Acliad/XBOX-Sign/Hardware/Light Board - O/Release/Production/BOM.csv

Reference | Description | Qty | Comment | LCSC | MPN
D1, D2, D3, D4, D5, D6, D7, D8 | Light emitting diode, filled shape | 8 |  |  | JB2835AWT-W-H40GA0000-N0000001
