Acliad/XBOX-Sign/Hardware/Control Board/Mechanical/Board Outline.dxf

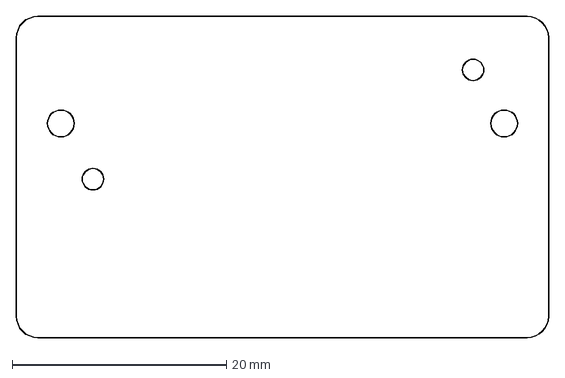
[picture p1: CAD file, 2025-08-16]
Hardware/Control Board/Mechanical/Board Outline.dxf
49.7 x 30.0 mm
