Acliad/XBOX-Sign/Hardware/Light Board - B/Mechanical/Board Outline.dxf

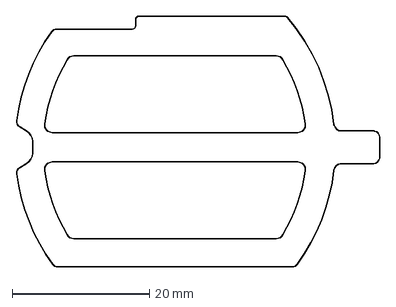
[picture p2: CAD file, 2025-08-16]
Hardware/Light Board - B/Mechanical/Board Outline.dxf
53.0 x 36.6 mm
