Acliad/XBOX-Sign/Hardware/Light Board - B/Release/Mechanical/Light Board - B.step

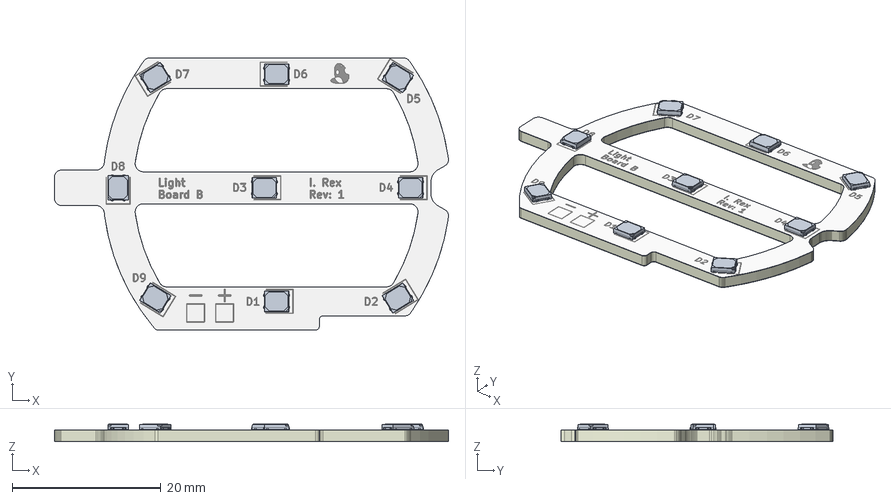
[picture p3: CAD file, 2025-08-30]
Hardware/Light Board - B/Release/Mechanical/Light Board - B.step
53.0 x 36.6 x 2.36 mm
Light Board - B 1.1.1 x 9
Light Board - B_silkscreen
Light Board - B_soldermask
Light Board - B_PCB
