Acliad/XBOX-Sign/Hardware/Light Board - O/Release/Mechanical/Light Board - O.step

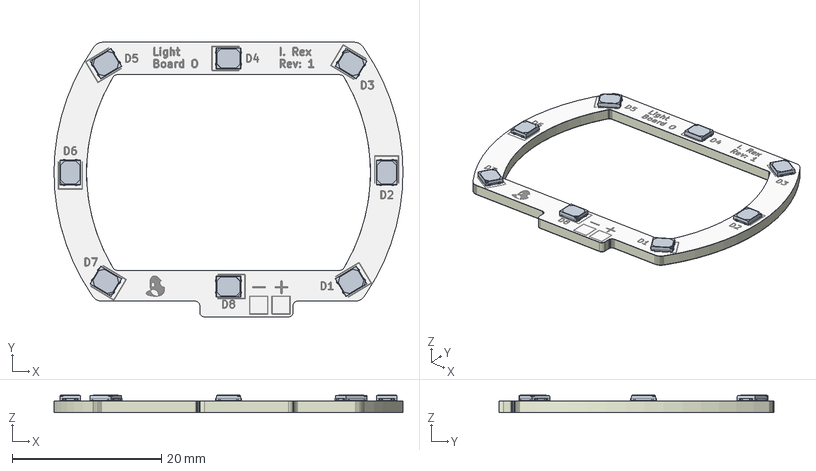
[picture p4: CAD file, 2025-08-30]
Hardware/Light Board - O/Release/Mechanical/Light Board - O.step
46.8 x 36.8 x 2.36 mm
Light Board - O 1.1.1 x 8
Light Board - O_silkscreen
Light Board - O_soldermask
Light Board - O_PCB
