Acliad/XBOX-Sign/Hardware/Light Board - Symbol/Mechanical/LED Placement.dxf

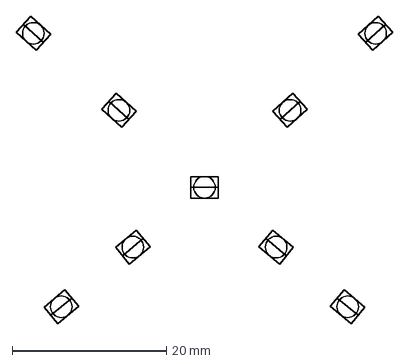
[picture p5: CAD file, 2025-08-16]
Hardware/Light Board - Symbol/Mechanical/LED Placement.dxf
48.8 x 39.8 mm
