Acliad/XBOX-Sign/Hardware/Light Board - Symbol/Release/Mechanical/Light Board - Symbol.step

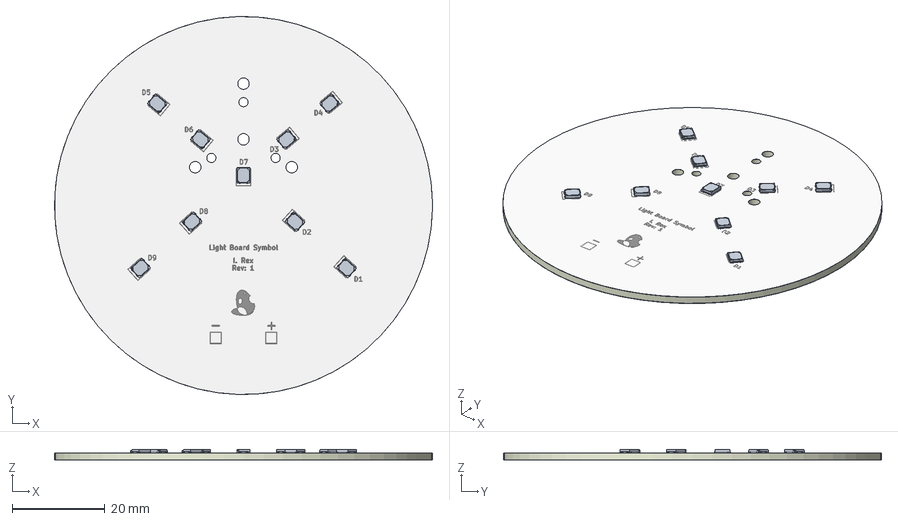
[picture p6: CAD file, 2025-08-30]
Hardware/Light Board - Symbol/Release/Mechanical/Light Board - Symbol.step
81.4 x 81.4 x 2.36 mm
Light Board - Symbol 1.1.1 x 9
Light Board - Symbol_silkscreen
Light Board - Symbol_soldermask
Light Board - Symbol_PCB
