Acliad/XBOX-Sign/Hardware/Light Board - X/Release/Mechanical/Light Board - X.step

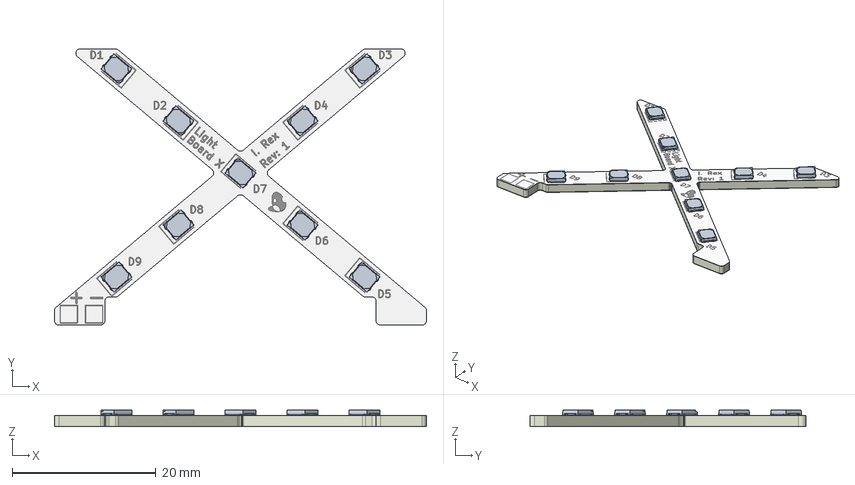
[picture p7: CAD file, 2025-08-30]
Hardware/Light Board - X/Release/Mechanical/Light Board - X.step
51.7 x 38.4 x 2.36 mm
Light Board - X 1.1.1 x 9
Light Board - X_silkscreen
Light Board - X_soldermask
Light Board - X_PCB
