Acliad/XBOX-Sign/Hardware/USB-C Board/Mechanical/Board Outline.dxf

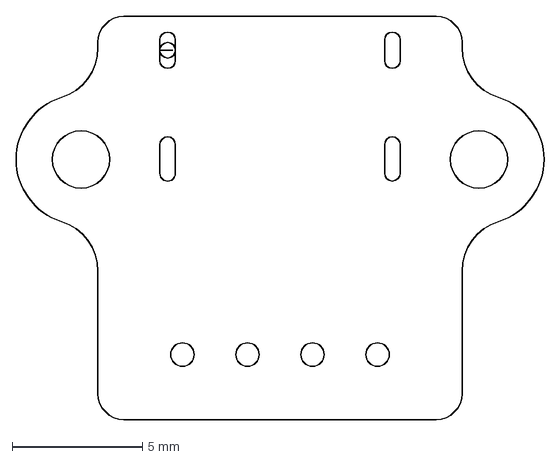
[picture p8: CAD file, 2025-08-16]
Hardware/USB-C Board/Mechanical/Board Outline.dxf
20.3 x 15.5 mm
