Acliad/XBOX-Sign/Hardware/USB-C Board/Release/Mechanical/USB-C Board.step

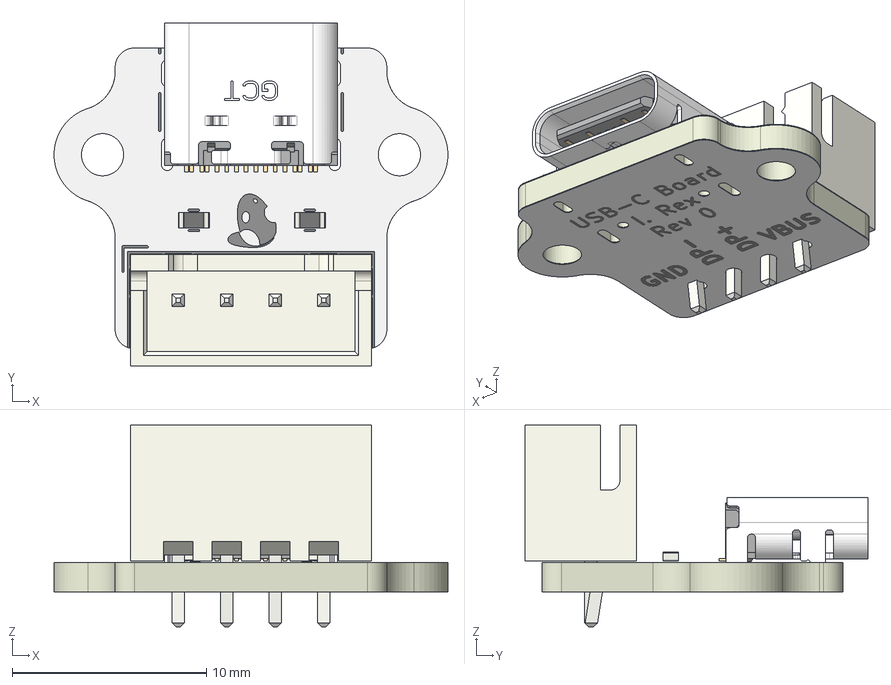
[picture p9: CAD file, 2025-08-16]
Hardware/USB-C Board/Release/Mechanical/USB-C Board.step
20.3 x 17.7 x 10.4 mm
R_0603_1608Metric x 2
JST_XH_B4B-XH-A_1x04_P2.50mm_Vertical
USB4105-15-A-120_PART2
USB4105-15-A-120_PART1
USB-C Board_silkscreen
USB-C Board_soldermask
USB-C Board_PCB
