Acliad/XBOX-Sign/Hardware/Light Board - B/Mechanical/LED Placement.dxf

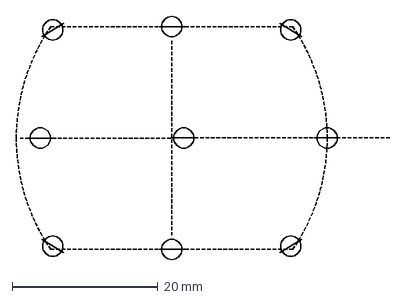
[picture p10: CAD file, 2025-08-16]
Hardware/Light Board - B/Mechanical/LED Placement.dxf
51.2 x 33.4 mm
