Acliad/XBOX-Sign/Hardware/Light Board - Symbol/Mechanical/Board Outline.dxf

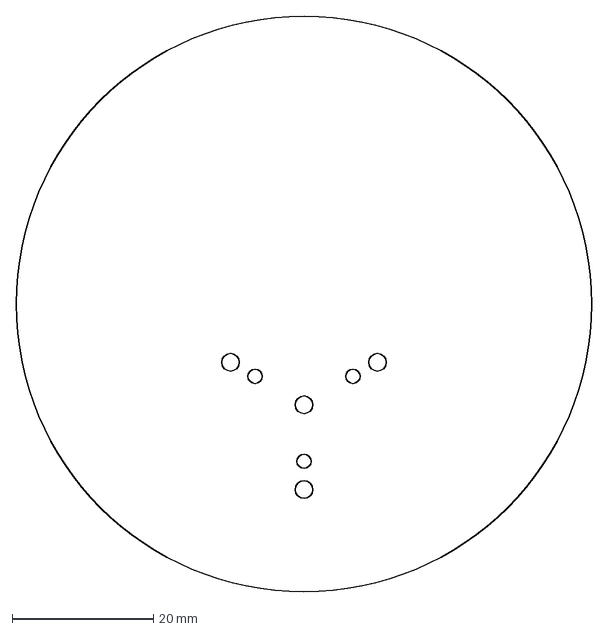
[picture p11: CAD file, 2025-08-16]
Hardware/Light Board - Symbol/Mechanical/Board Outline.dxf
81.4 x 81.4 mm
