Acliad/XBOX-Sign/Hardware/Light Board - O/Mechanical/LED Placement.dxf

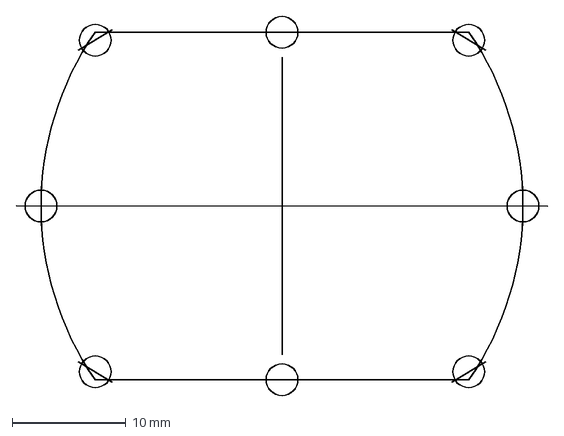
[picture p12: CAD file, 2025-08-11, an earlier design]
Hardware/Light Board - O/Mechanical/LED Placement.dxf
46.8 x 33.4 mm
