Acliad/XBOX-Sign/Hardware/Light Board - X/Mechanical/LED Placement.dxf

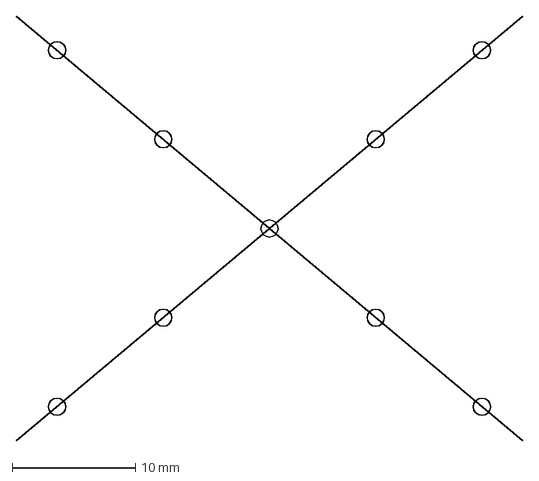
[picture p13: CAD file, 2025-08-10, an earlier design]
Hardware/Light Board - X/Mechanical/LED Placement.dxf
41.1 x 34.5 mm
