Acliad/XBOX-Sign/Hardware/Light Board - O/Mechanical/Board Outline.dxf

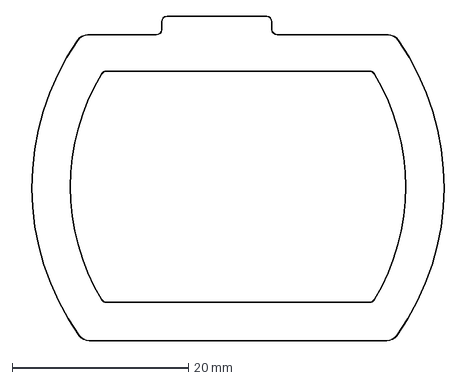
[picture p14: CAD file, 2025-08-11, an earlier design]
Hardware/Light Board - O/Mechanical/Board Outline.dxf
50.4 x 36.8 mm
