Acliad/XBOX-Sign/Hardware/Light Board - X/Mechanical/Board Outline.dxf

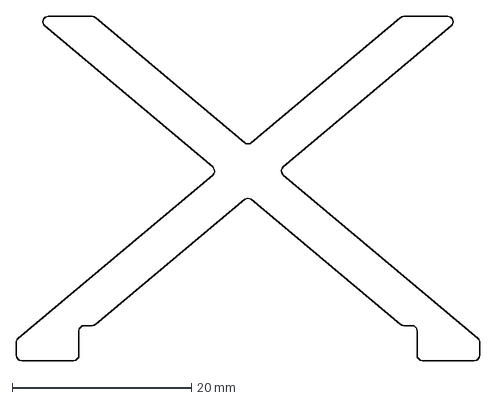
[picture p15: CAD file, 2025-08-10, an earlier design]
Hardware/Light Board - X/Mechanical/Board Outline.dxf
51.7 x 38.4 mm
