Acliad/XBOX-Sign/Hardware/Light Board - B/Release/PDFs/Light Board - B.pdf

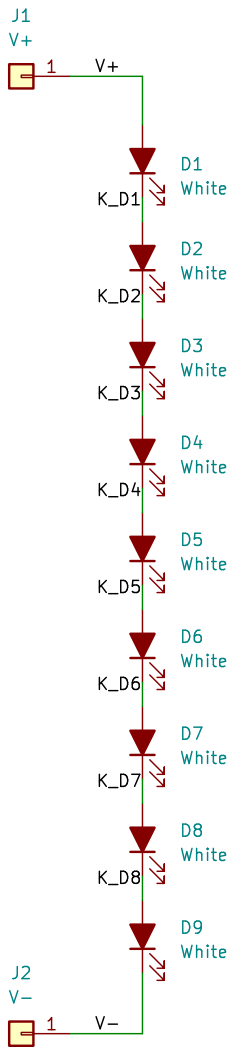
[picture p16: page 1]

File: Light Board - B.kicad_sch Light Board - B
