Acliad/XBOX-Sign/Hardware/Light Board - B/Release/PDFs/Light Board - B_ASY.pdf

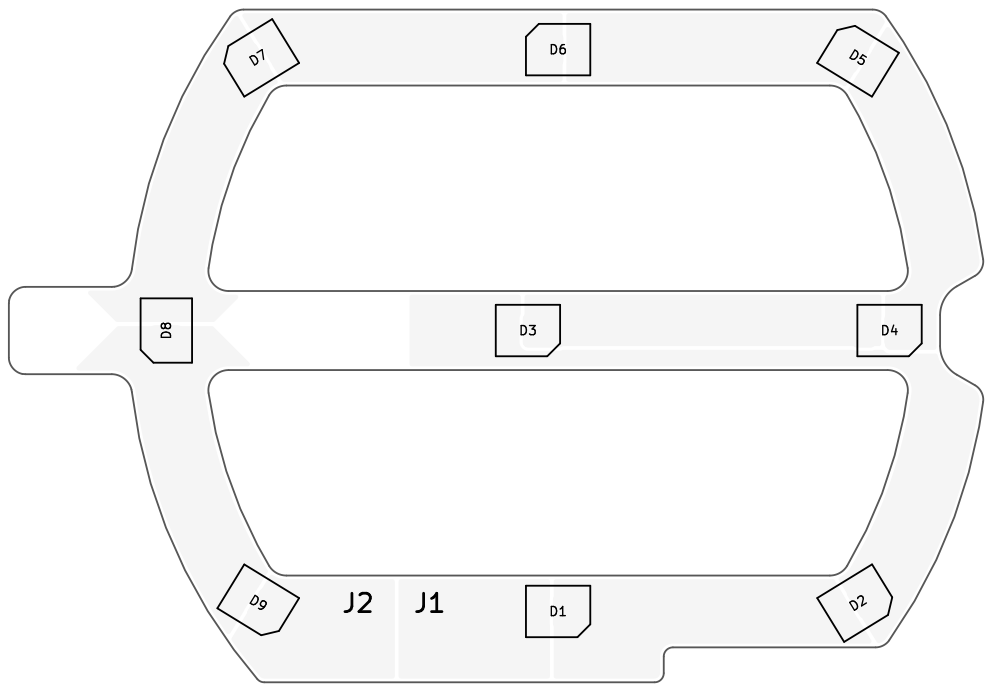
[picture p17: page 1]

File: Light Board - B.kicad_pcb Light Board - B

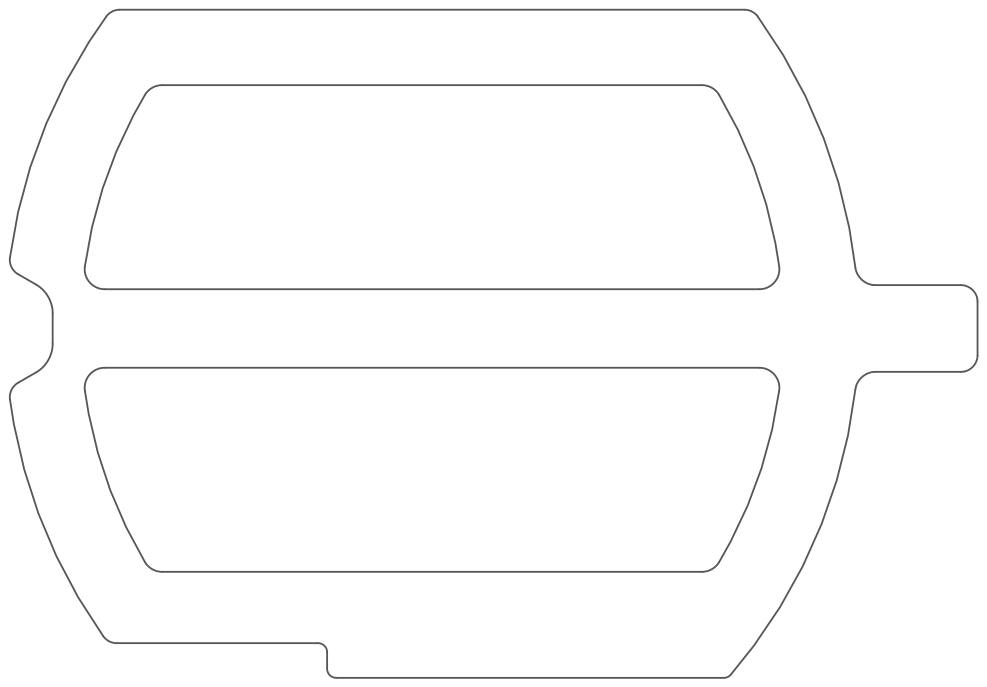
[picture p18: page 2]
D Date: 2025-08-10 Rev: 1; Size: A; Engineer: Isaac; Rex; ECAD Version; ${KICAD_VERSION}

File: Light Board - B.kicad_pcb Light Board - B
Sheet: 2/2 Assembly - Bottom
