Acliad/XBOX-Sign/Hardware/Light Board - B/Release/PDFs/Light Board - B_FAB.pdf

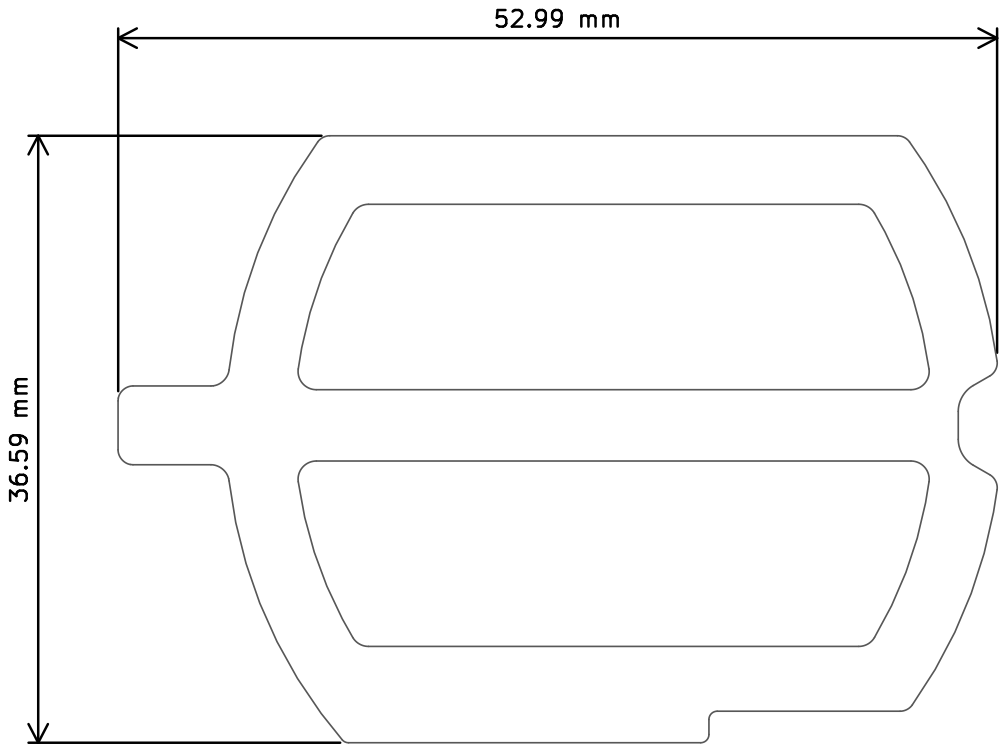
[picture p19: page 1]
D Date: 2025-08-10 Rev: 1; Size: A; Sheet:; 1/7 Fab Drawing; Engineer: Isaac; Rex; ECAD Version; ${KICAD_VERSION}

File: Light Board - B.kicad_pcb Light Board - B

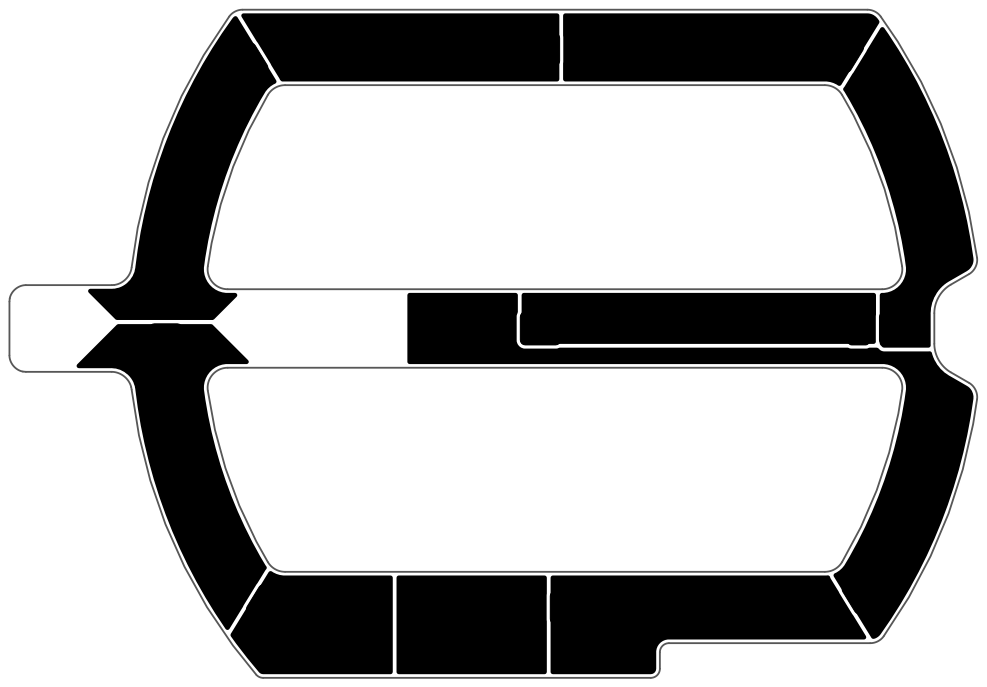
[picture p20: page 2]
D Date: 2025-08-10 Rev: 1; Size: A; Sheet: 2/7 Copper - L1; Engineer: Isaac; Rex; ECAD Version

File: Light Board - B.kicad_pcb Light Board - B

File: Light Board - B.kicad_pcb Light Board - B

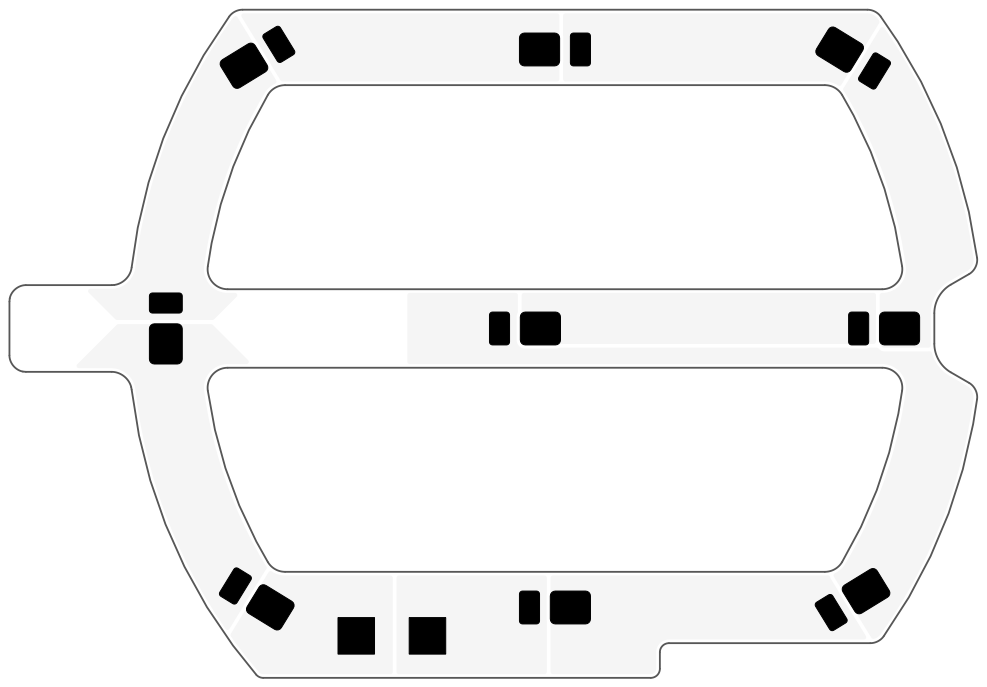
[picture p21: page 4]
D Date: 2025-08-10 Rev: 1; Size: A; Engineer: Isaac; Rex; ECAD Version

File: Light Board - B.kicad_pcb Light Board - B
Sheet: 4/7 Soldermask - Top

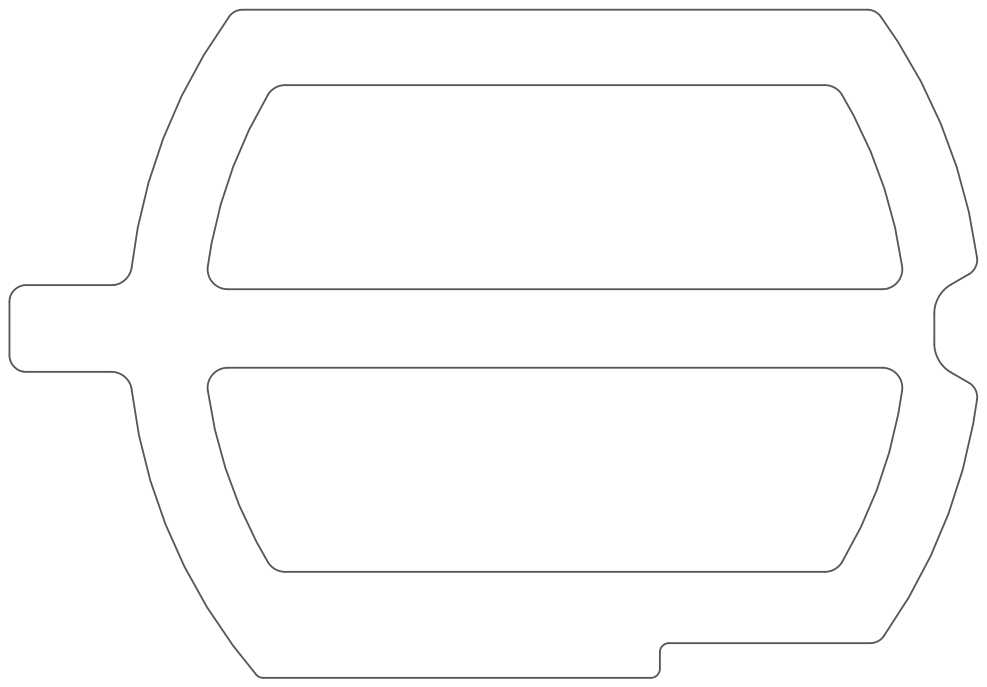
[picture p22: page 5]
D Date: 2025-08-10 Rev: 1; Size: A; Engineer: Isaac; Rex; ECAD Version

File: Light Board - B.kicad_pcb Light Board - B
Sheet: 5/7 Soldermask - Bottom

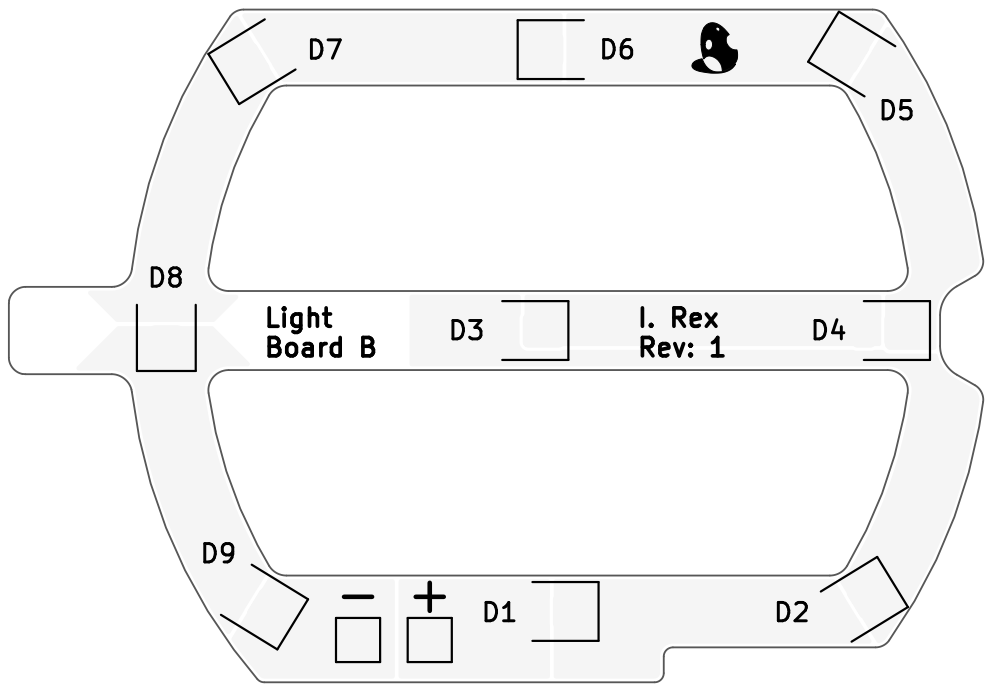
[picture p23: page 6]

File: Light Board - B.kicad_pcb Light Board - B
Sheet: 6/7 Silkscreen - Top

File: Light Board - B.kicad_pcb Light Board - B
Sheet: 7/7 Silk - Bottom
