Acliad/XBOX-Sign/Hardware/Light Board - O/Release/PDFs/Light Board - O.pdf

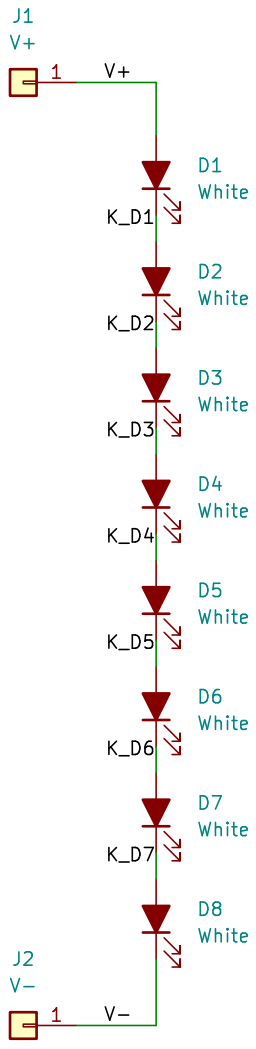
[picture p24: page 1]

File: Light Board - O.kicad_sch Light Board - O
