Acliad/XBOX-Sign/Hardware/Light Board - O/Release/PDFs/Light Board - O_ASY.pdf

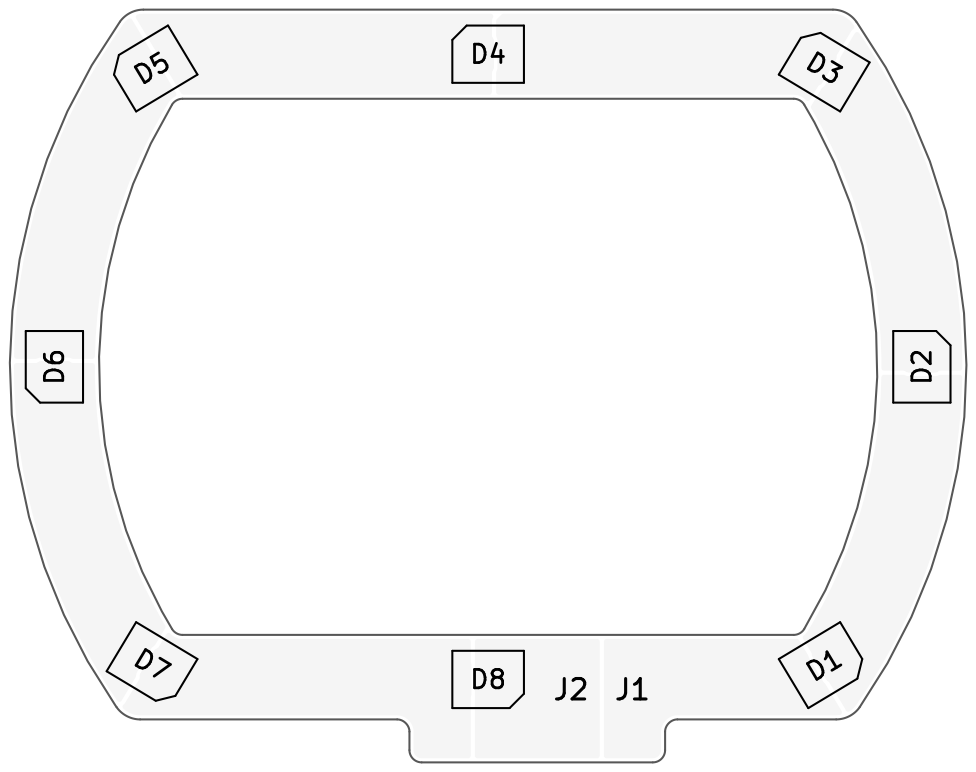
[picture p25: page 1]
D Date: 2025-08-10 Rev: 1; Size: A; Sheet:; 1/2 Assembly - Top; Engineer: Isaac; Rex; ECAD Version; ${KICAD_VERSION}

File: Light Board - O.kicad_pcb Light Board - O

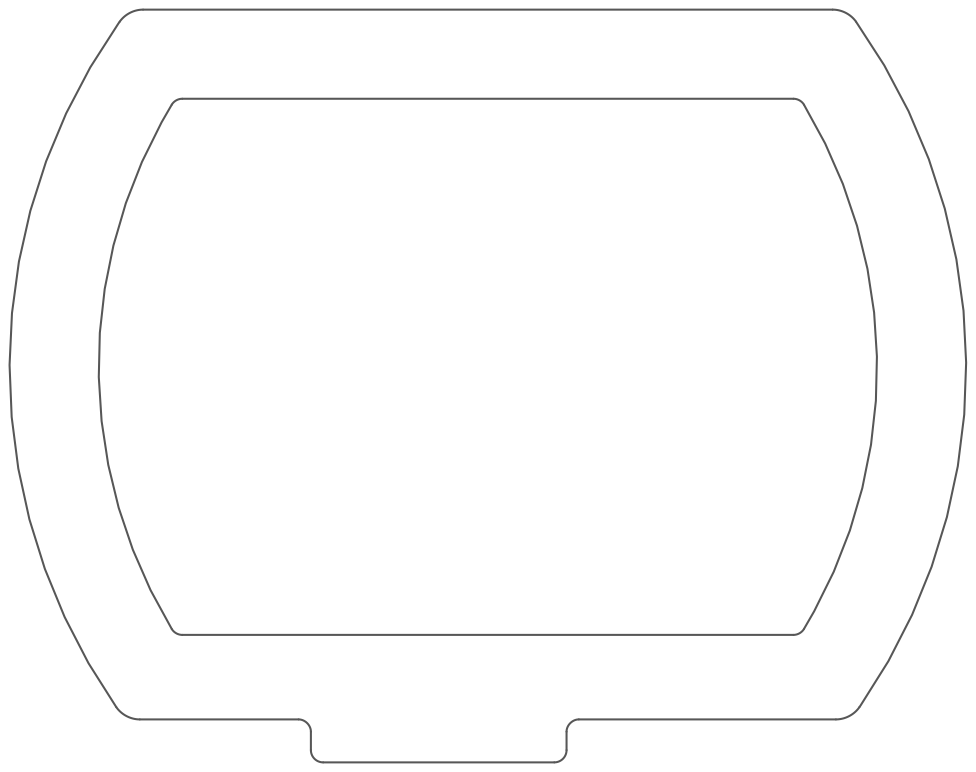
[picture p26: page 2]
D Date: 2025-08-10 Rev: 1; Size: A; Engineer: Isaac; Rex; ECAD Version; ${KICAD_VERSION}

File: Light Board - O.kicad_pcb Light Board - O
Sheet: 2/2 Assembly - Bottom
