Acliad/XBOX-Sign/Hardware/Light Board - O/Release/PDFs/Light Board - O_FAB.pdf

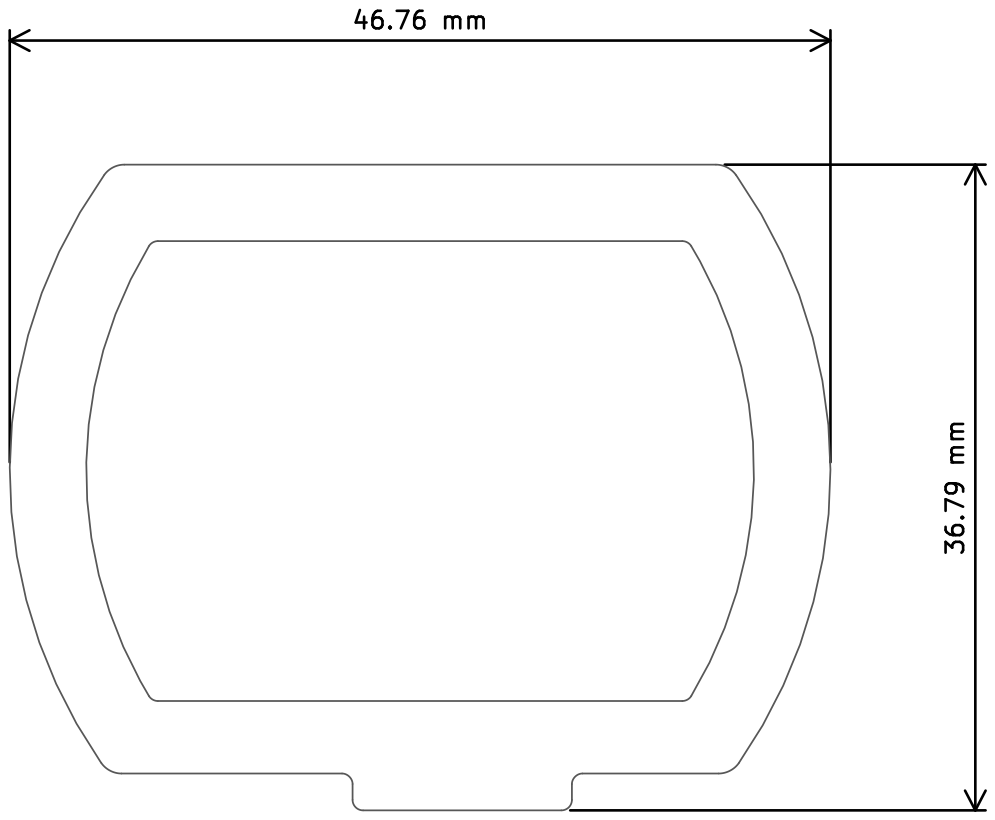
[picture p27: page 1]
D Date: 2025-08-10 Rev: 1; Size: A; Sheet:; 1/7 Fab Drawing; Engineer: Isaac; Rex; ECAD Version; ${KICAD_VERSION}

File: Light Board - O.kicad_pcb Light Board - O

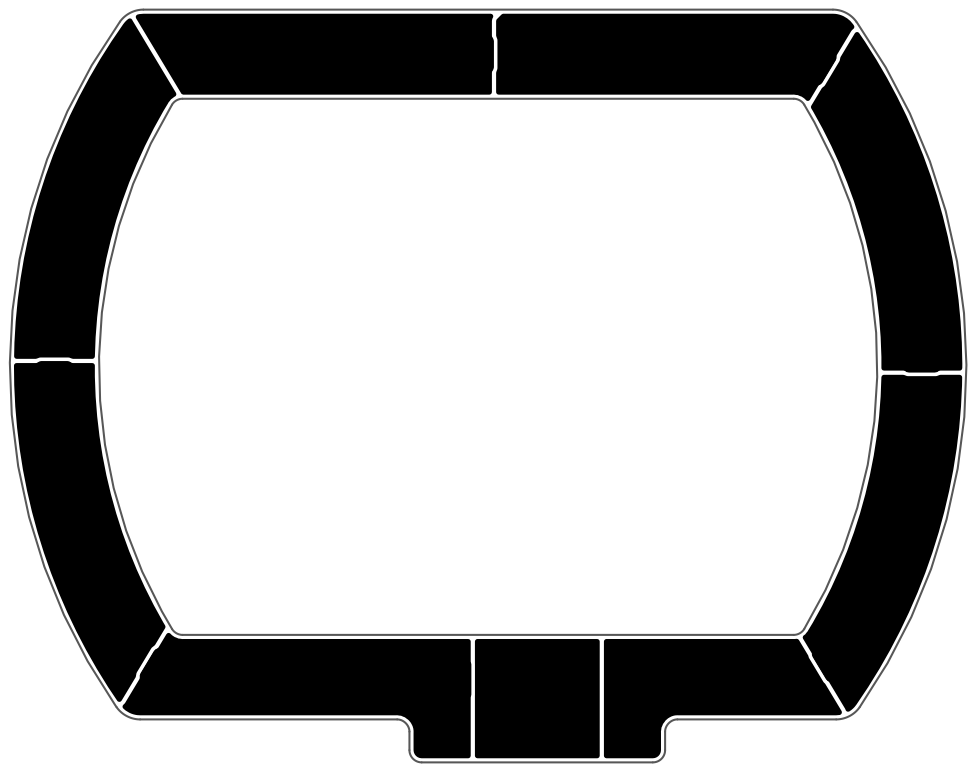
[picture p28: page 2]
D Date: 2025-08-10 Rev: 1; Size: A; Sheet: 2/7 Copper - L1; Engineer: Isaac; Rex; ECAD Version

File: Light Board - O.kicad_pcb Light Board - O

File: Light Board - O.kicad_pcb Light Board - O

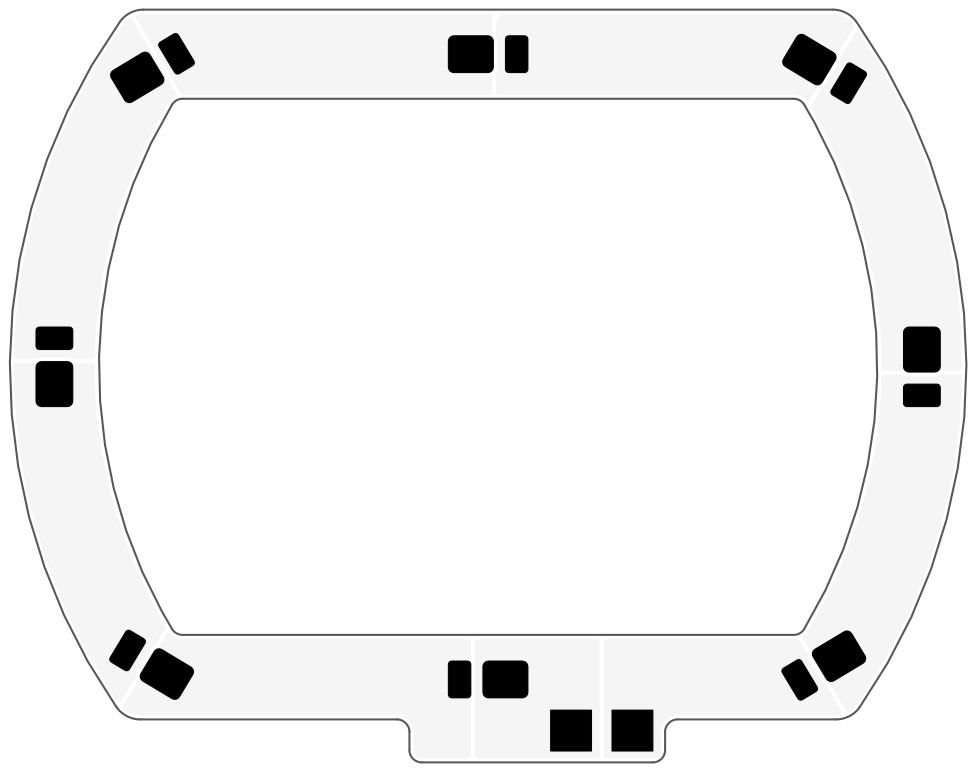
[picture p29: page 4]
D Date: 2025-08-10 Rev: 1; Size: A; Engineer: Isaac; Rex; ECAD Version

File: Light Board - O.kicad_pcb Light Board - O
Sheet: 4/7 Soldermask - Top

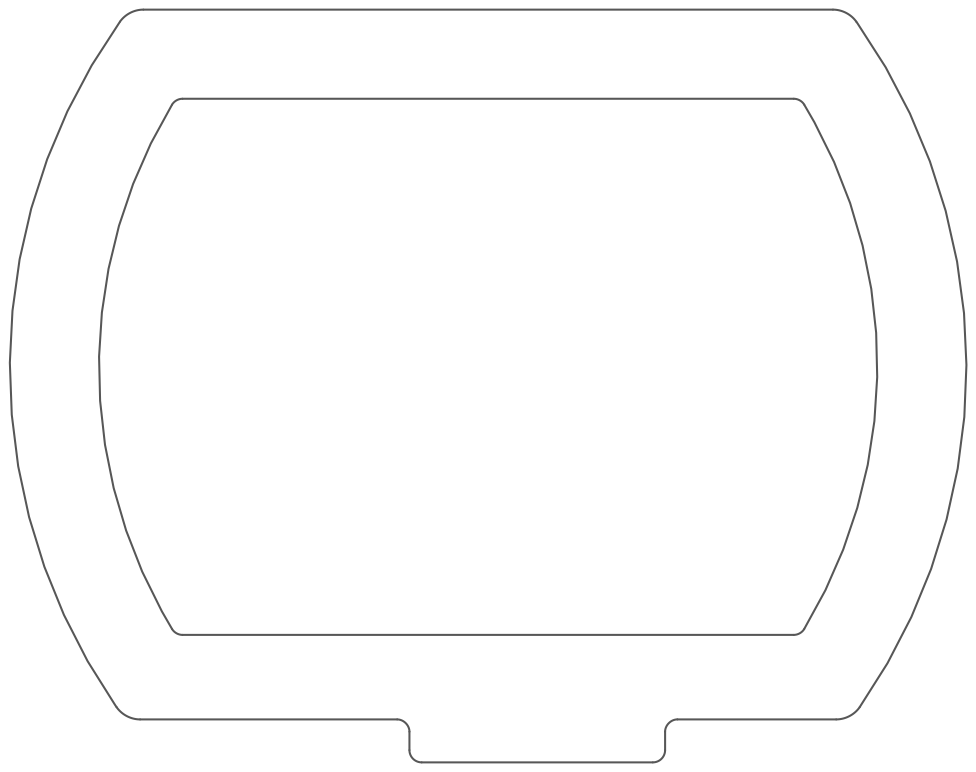
[picture p30: page 5]
D Date: 2025-08-10 Rev: 1; Size: A; Engineer: Isaac; Rex; ECAD Version

File: Light Board - O.kicad_pcb Light Board - O
Sheet: 5/7 Soldermask - Bottom

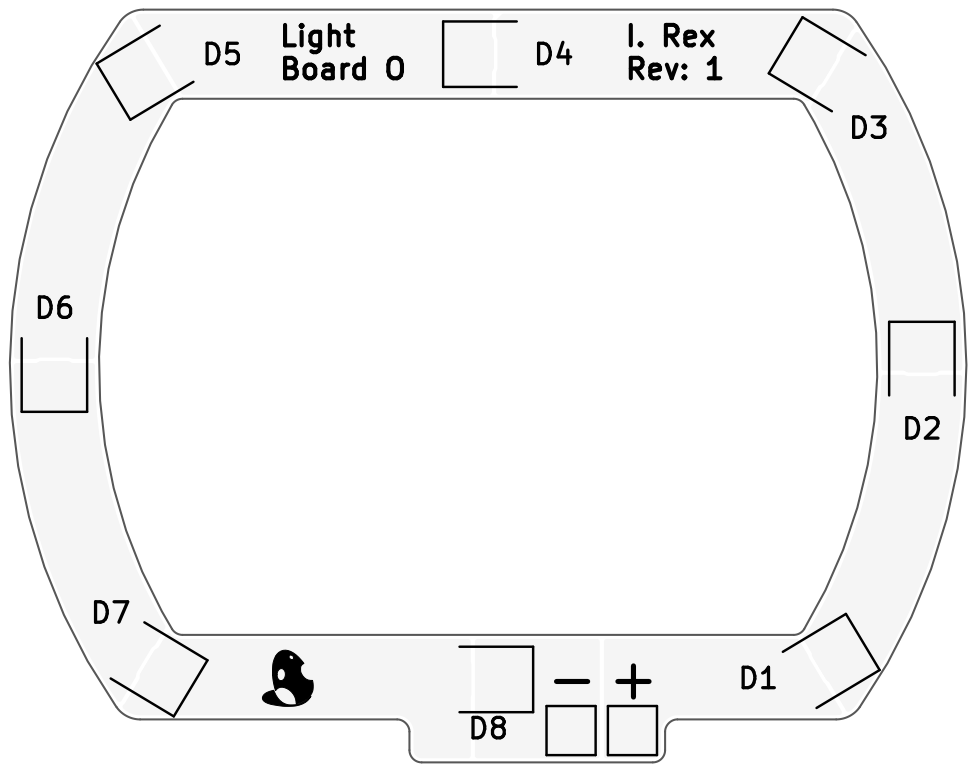
[picture p31: page 6]

File: Light Board - O.kicad_pcb Light Board - O
Sheet: 6/7 Silkscreen - Top

File: Light Board - O.kicad_pcb Light Board - O
Sheet: 7/7 Silk - Bottom
