Acliad/XBOX-Sign/Hardware/Light Board - Symbol/Release/PDFs/Light Board - Symbol.pdf

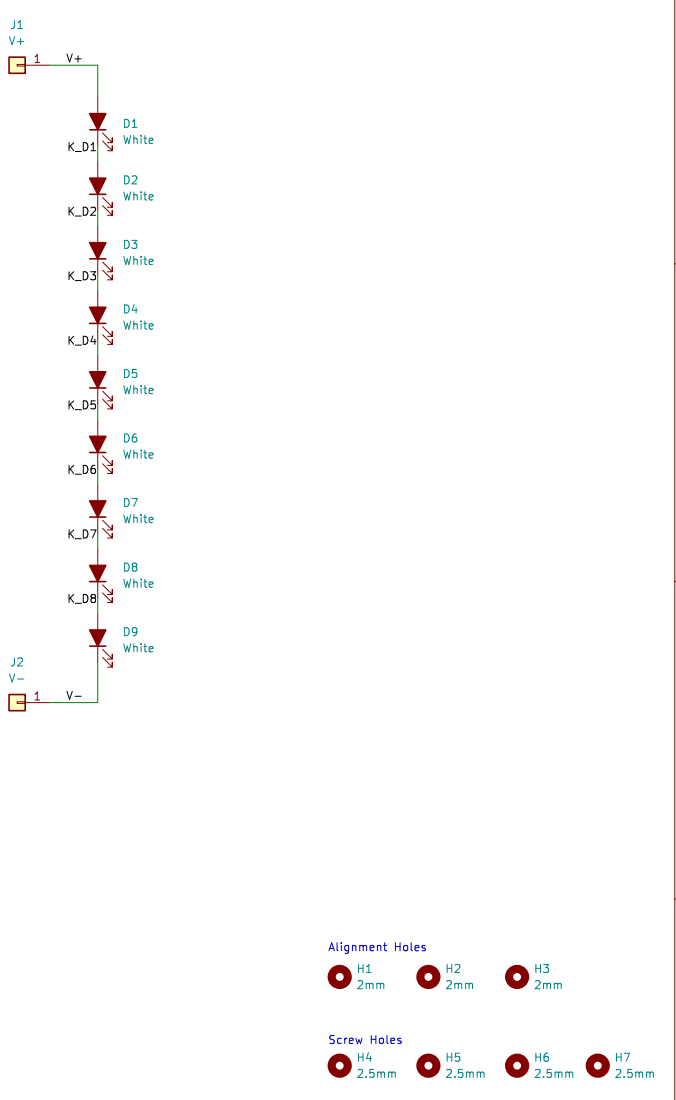
[picture p32: page 1]

File: Light Board - Symbol.kicad_sch Light Board - Symbol
