Acliad/XBOX-Sign/Hardware/Light Board - Symbol/Release/PDFs/Light Board - Symbol_ASY.pdf

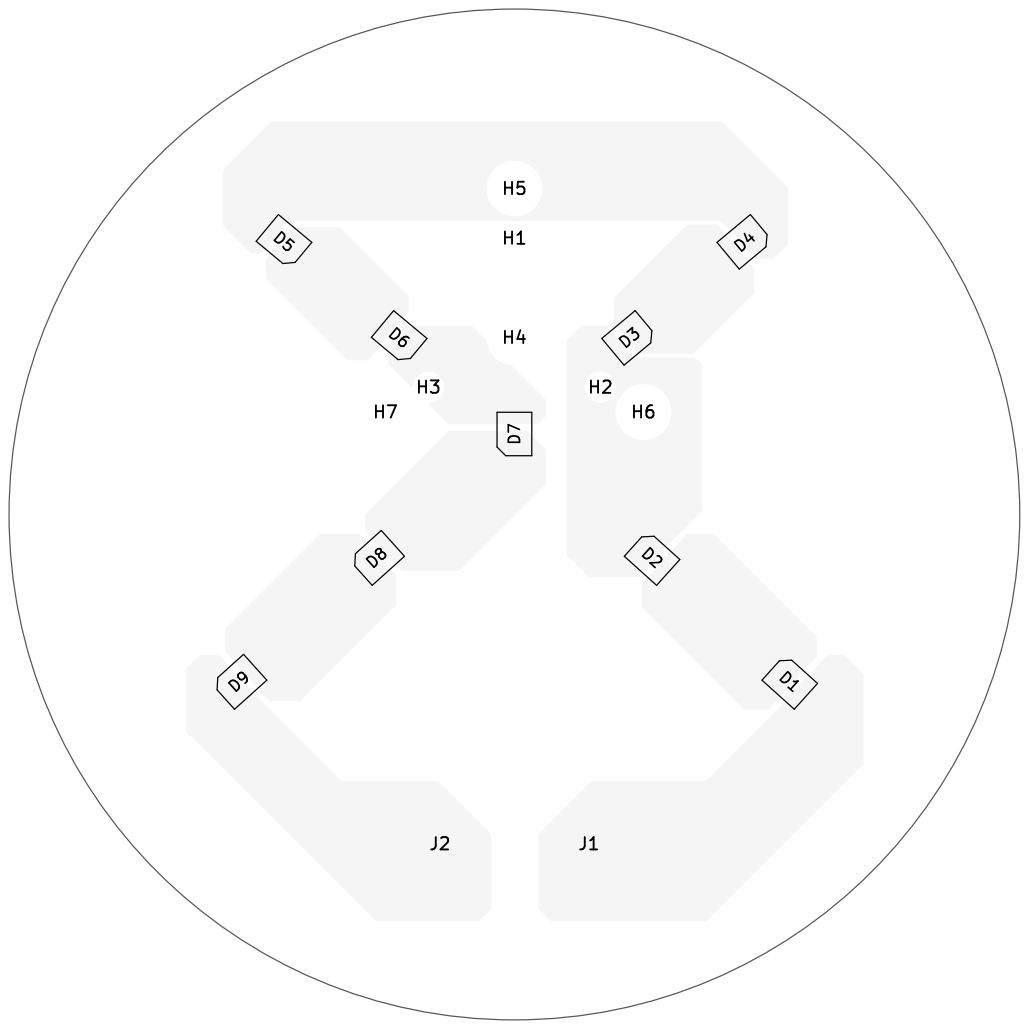
[picture p33: page 1]

File: Light Board - Symbol.kicad_pcb Light Board - Symbol

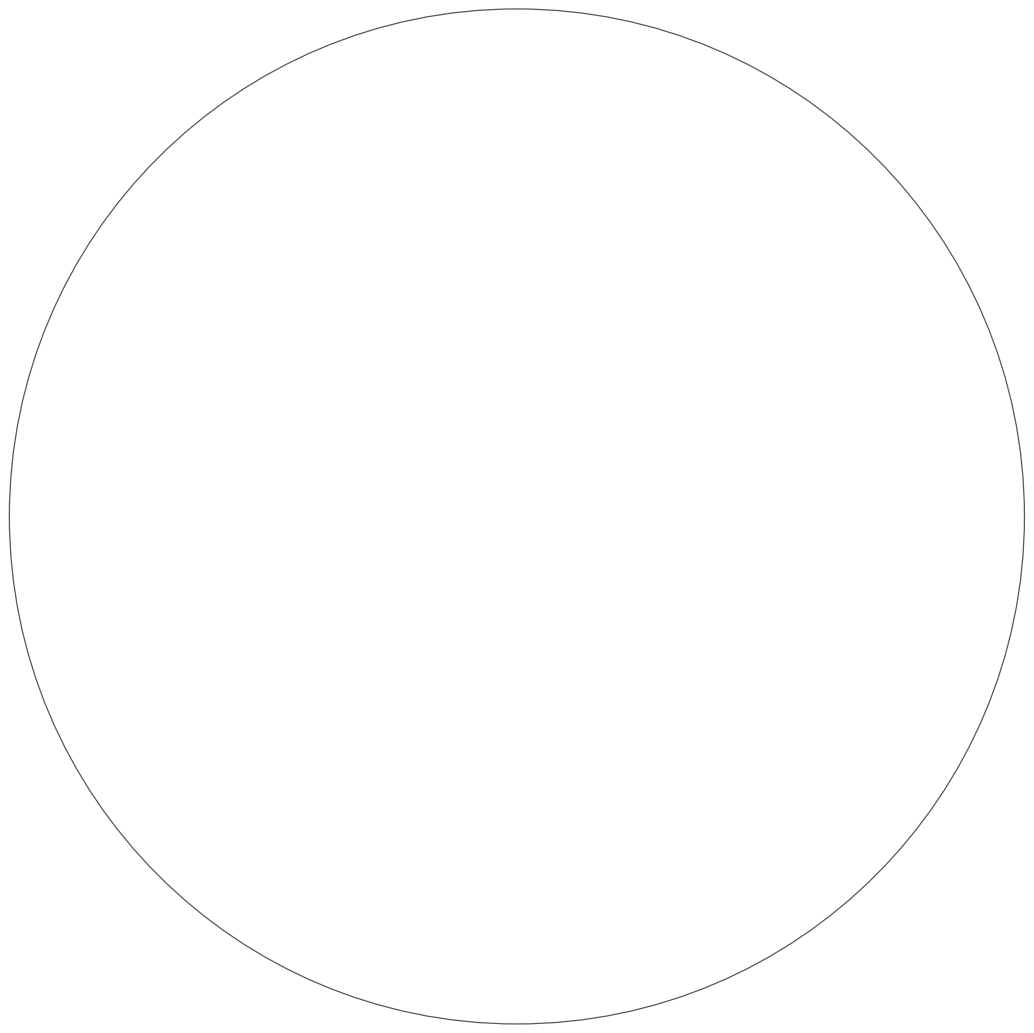
[picture p34: page 2]
D Date: 2025-08-10 Rev: 1; Size: A; Engineer: Isaac; Rex; ECAD Version; ${KICAD_VERSION}

File: Light Board - Symbol.kicad_pcb Light Board - Symbol
Sheet: 2/2 Assembly - Bottom
