Acliad/XBOX-Sign/Hardware/Light Board - Symbol/Release/PDFs/Light Board - Symbol_FAB.pdf

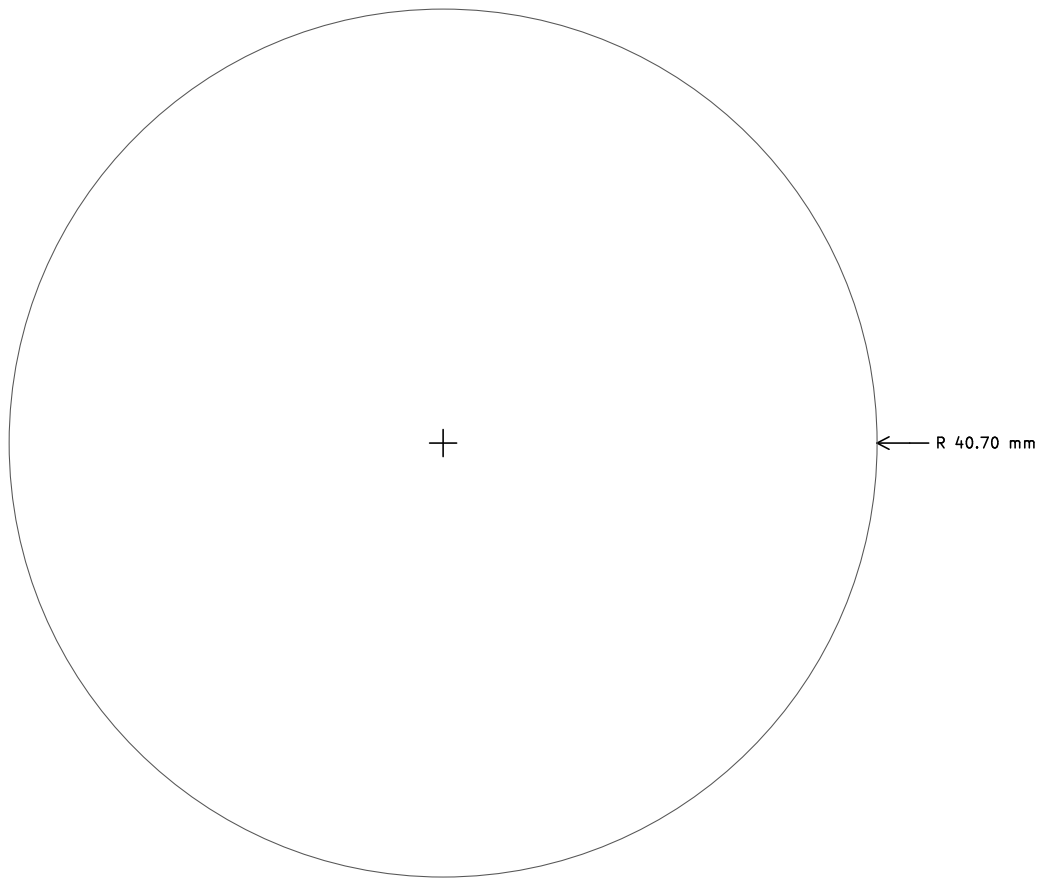
[picture p35: page 1]
D Date: 2025-08-10 Rev: 1; Size: A; Sheet:; 1/7 Fab Drawing; Engineer: Isaac; Rex; ECAD Version; ${KICAD_VERSION}

File: Light Board - Symbol.kicad_pcb Light Board - Symbol

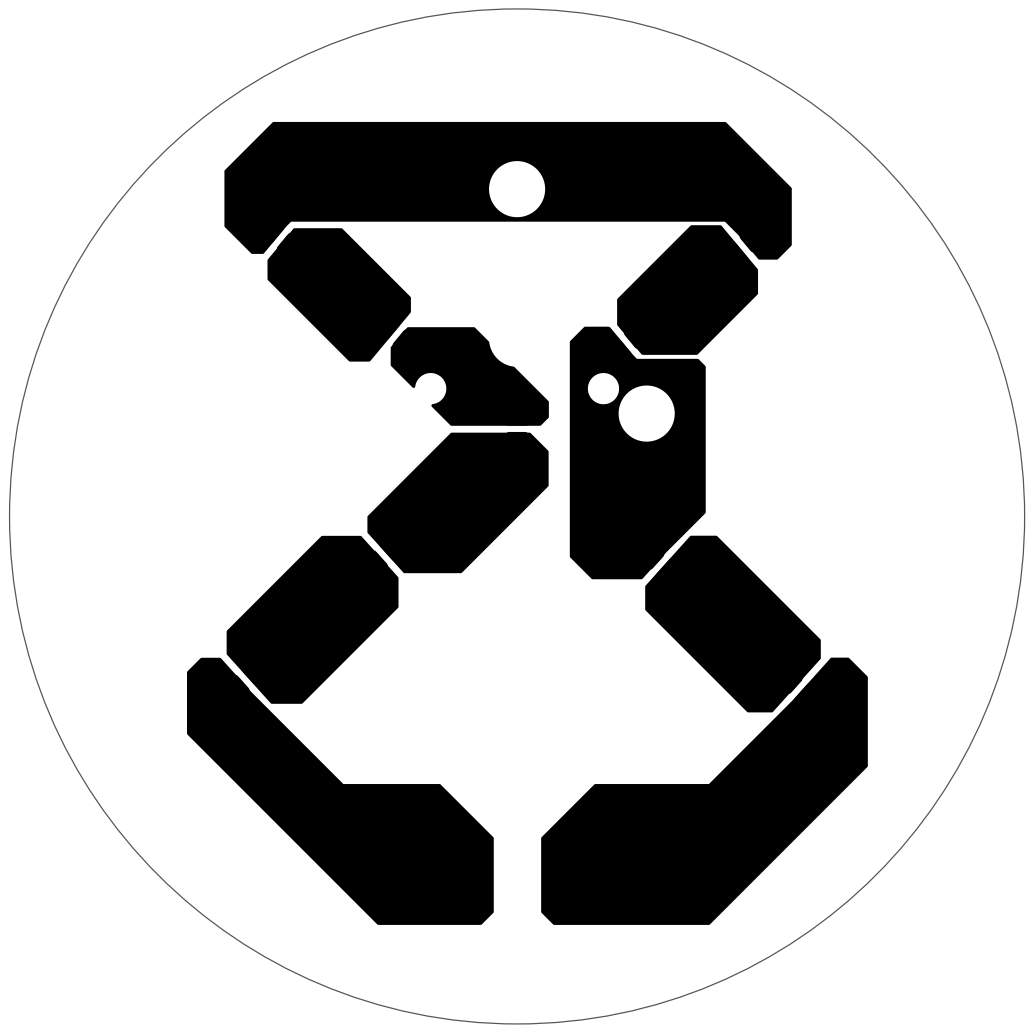
[picture p36: page 2]
D Date: 2025-08-10 Rev: 1; Size: A; Sheet: 2/7 Copper - L1; Engineer: Isaac; Rex; ECAD Version

File: Light Board - Symbol.kicad_pcb Light Board - Symbol

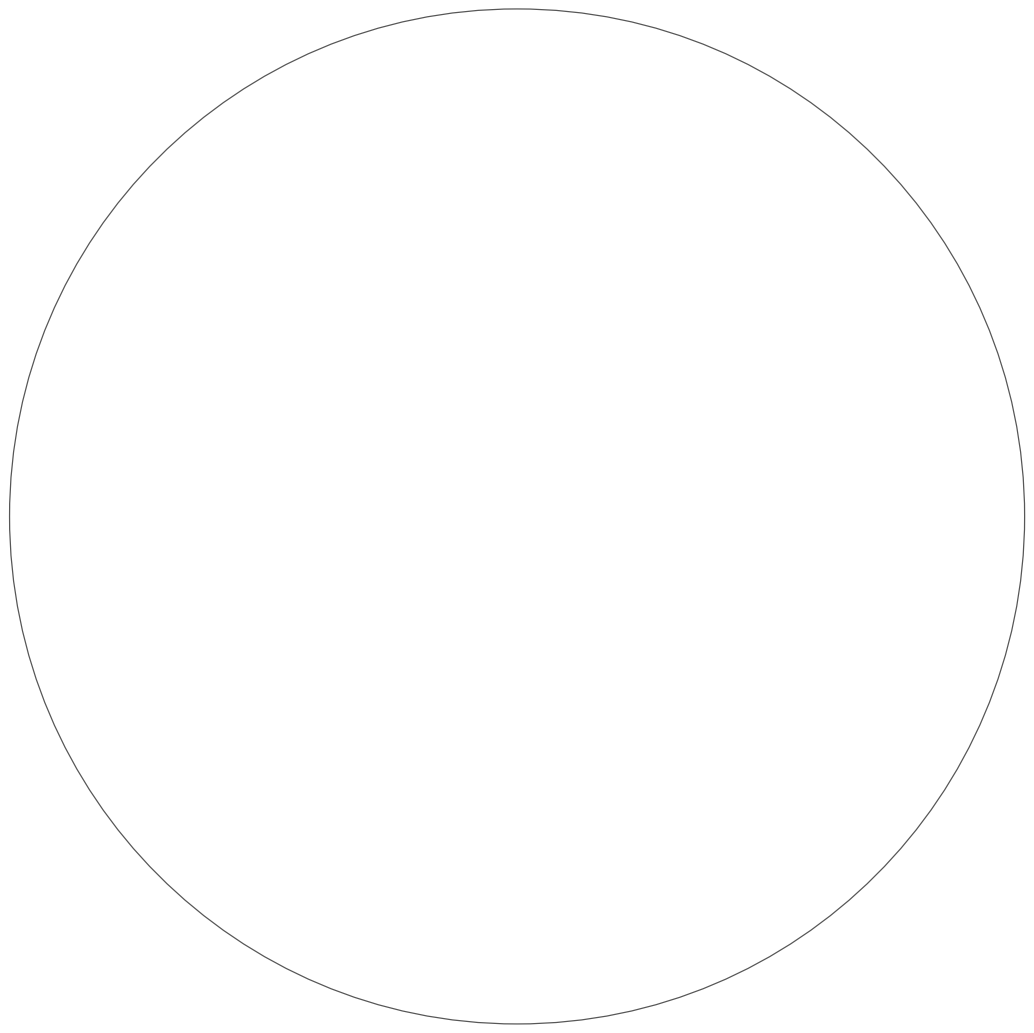
[picture p37: page 3]
D Date: 2025-08-10 Rev: 1; Size: A; Sheet: 3/7 Copper - L2; Engineer: Isaac; Rex; ECAD Version

File: Light Board - Symbol.kicad_pcb Light Board - Symbol

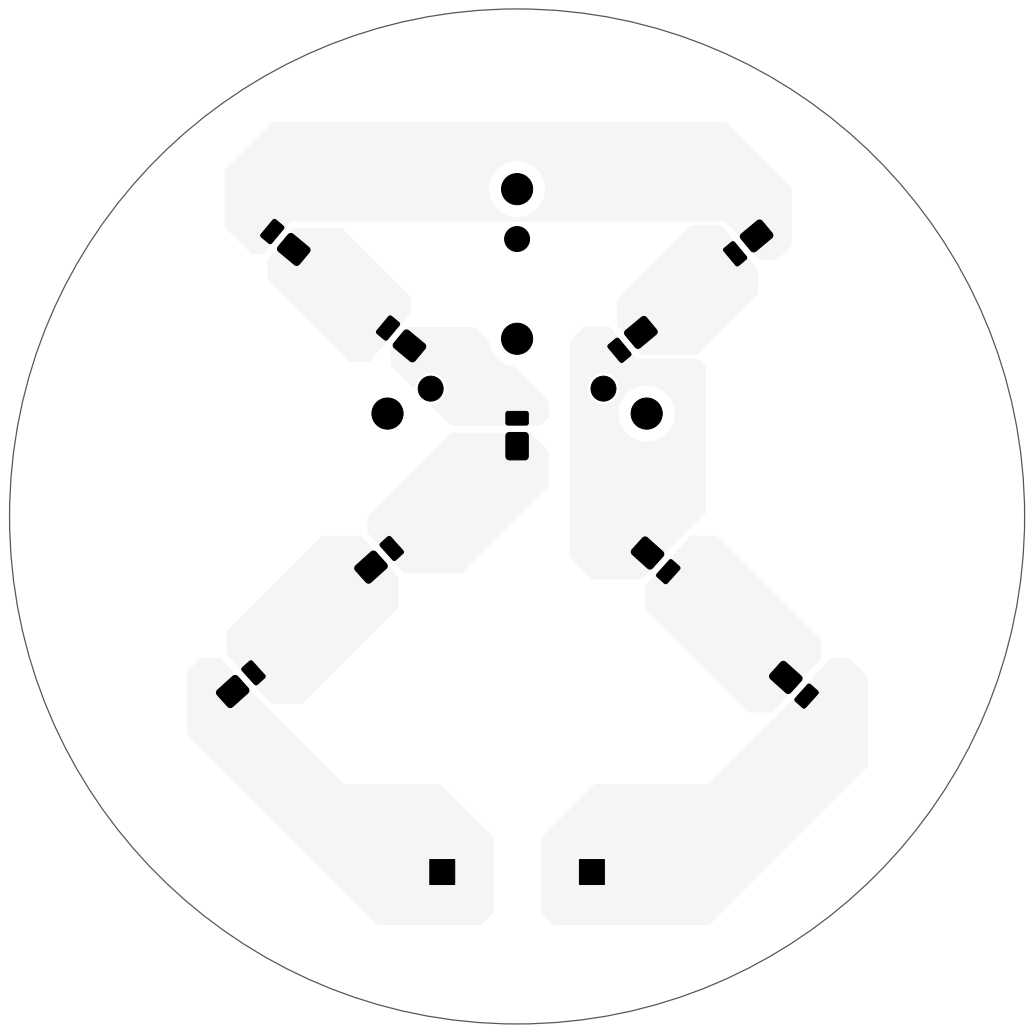
[picture p38: page 4]
D Date: 2025-08-10 Rev: 1; Size: A; Engineer: Isaac; Rex; ECAD Version

File: Light Board - Symbol.kicad_pcb Light Board - Symbol
Sheet: 4/7 Soldermask - Top

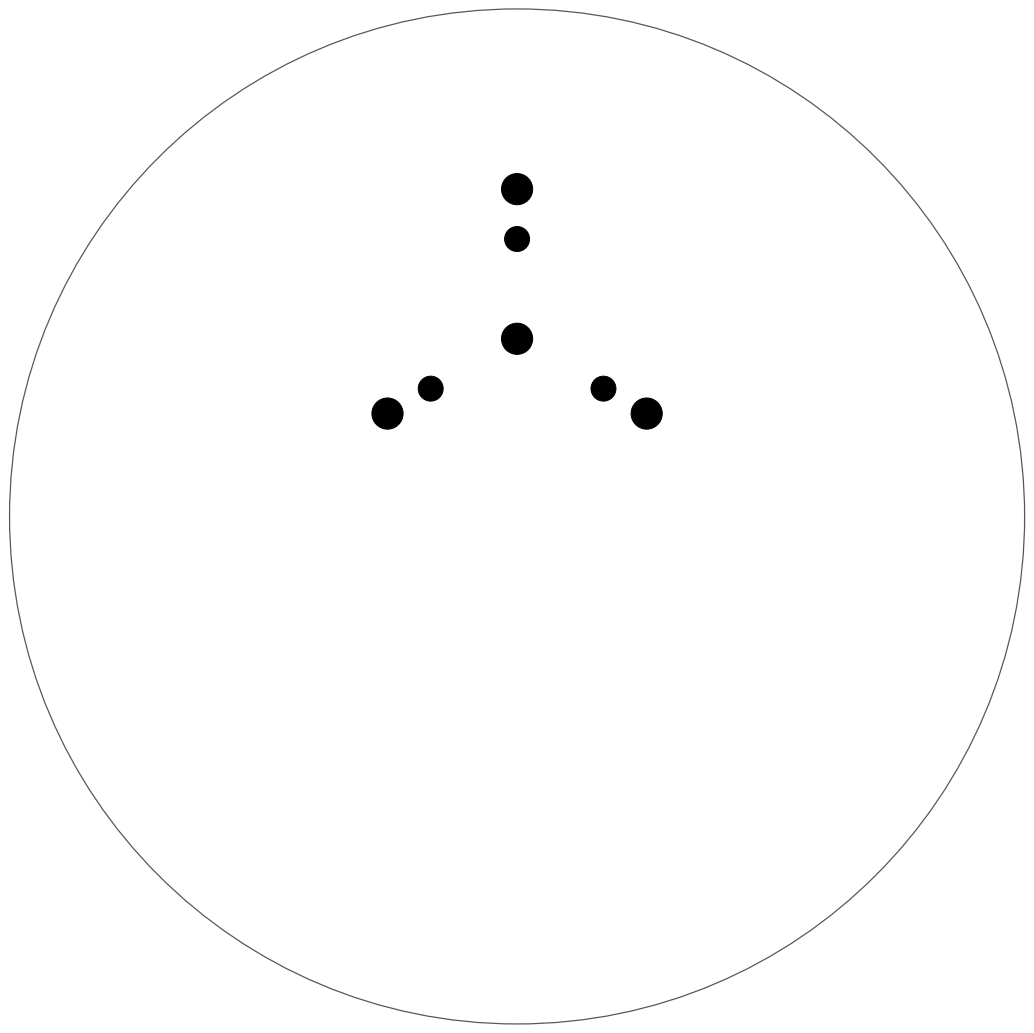
[picture p39: page 5]
D Date: 2025-08-10 Rev: 1; Size: A; Engineer: Isaac; Rex; ECAD Version

File: Light Board - Symbol.kicad_pcb Light Board - Symbol
Sheet: 5/7 Soldermask - Bottom

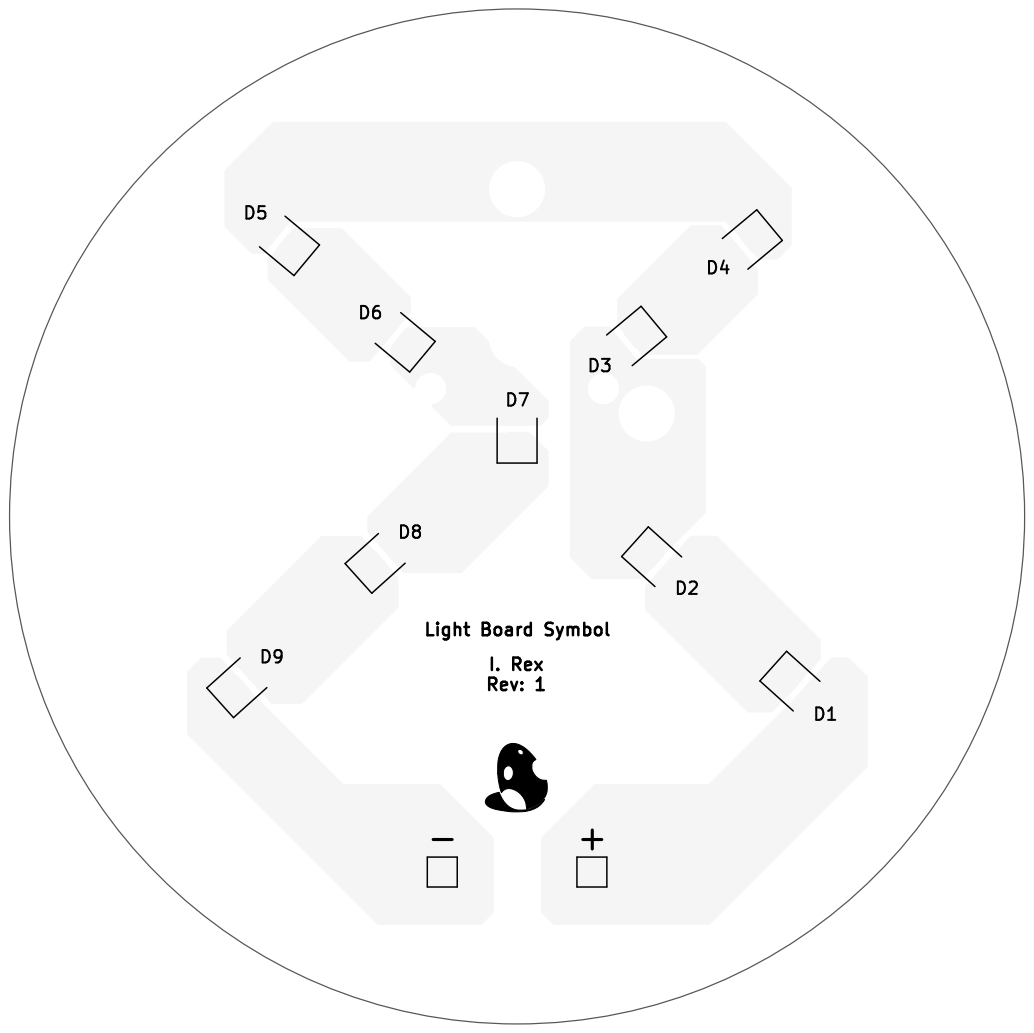
[picture p40: page 6]

File: Light Board - Symbol.kicad_pcb Light Board - Symbol
Sheet: 6/7 Silkscreen - Top

File: Light Board - Symbol.kicad_pcb Light Board - Symbol
Sheet: 7/7 Silk - Bottom
