Acliad/XBOX-Sign/Hardware/Light Board - X/Release/PDFs/Light Board - X.pdf

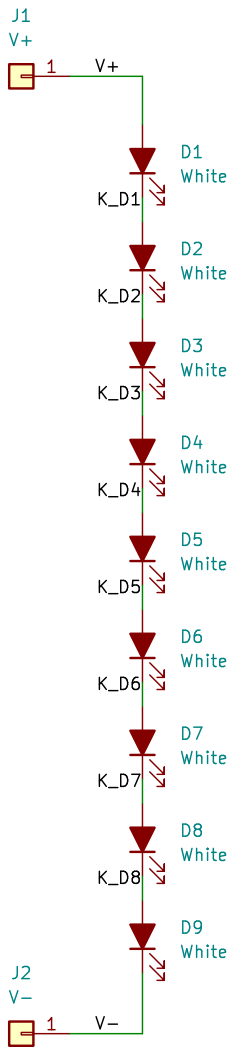
[picture p41: page 1]

File: Light Board - X.kicad_sch Light Board - X
