Acliad/XBOX-Sign/Hardware/Light Board - X/Release/PDFs/Light Board - X_ASY.pdf

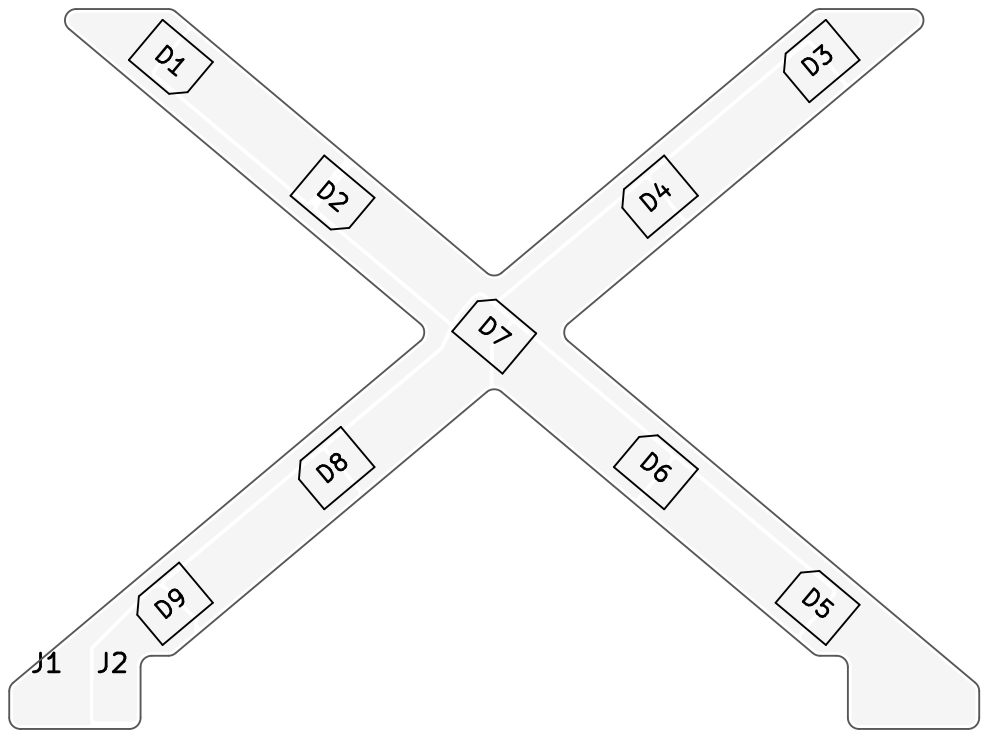
[picture p42: page 1]

File: Light Board - X.kicad_pcb Light Board - X

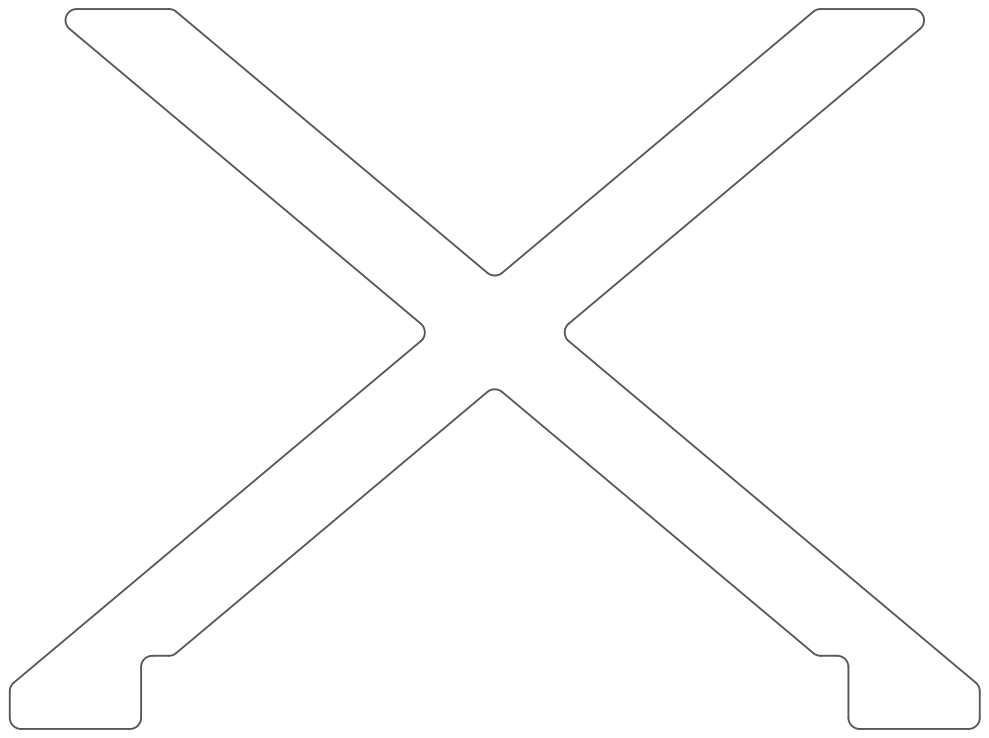
[picture p43: page 2]
D Date: 2025-08-10 Rev: 1; Size: A; Engineer: Isaac; Rex; ECAD Version; ${KICAD_VERSION}

File: Light Board - X.kicad_pcb Light Board - X
Sheet: 2/2 Assembly - Bottom
