Acliad/XBOX-Sign/Hardware/Light Board - X/Release/PDFs/Light Board - X_FAB.pdf

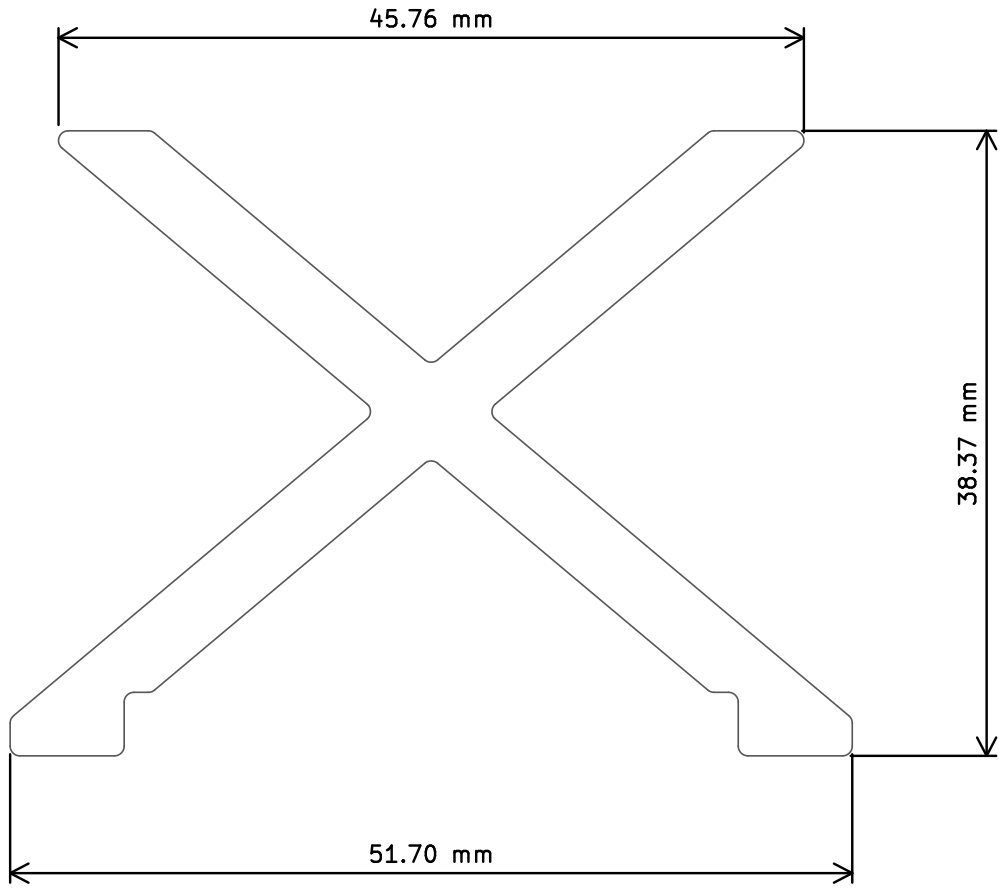
[picture p44: page 1]
D Date: 2025-08-10 Rev: 1; Size: A; Sheet:; 1/7 Fab Drawing; Engineer: Isaac; Rex; ECAD Version; ${KICAD_VERSION}

File: Light Board - X.kicad_pcb Light Board - X

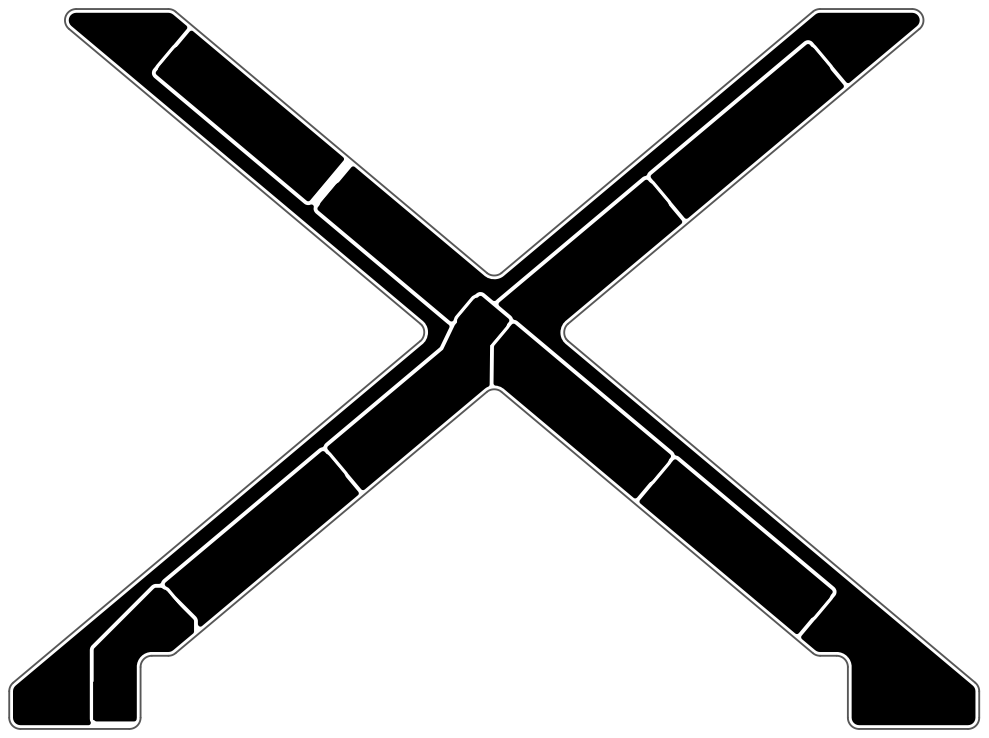
[picture p45: page 2]
D Date: 2025-08-10 Rev: 1; Size: A; Sheet: 2/7 Copper - L1; Engineer: Isaac; Rex; ECAD Version

File: Light Board - X.kicad_pcb Light Board - X

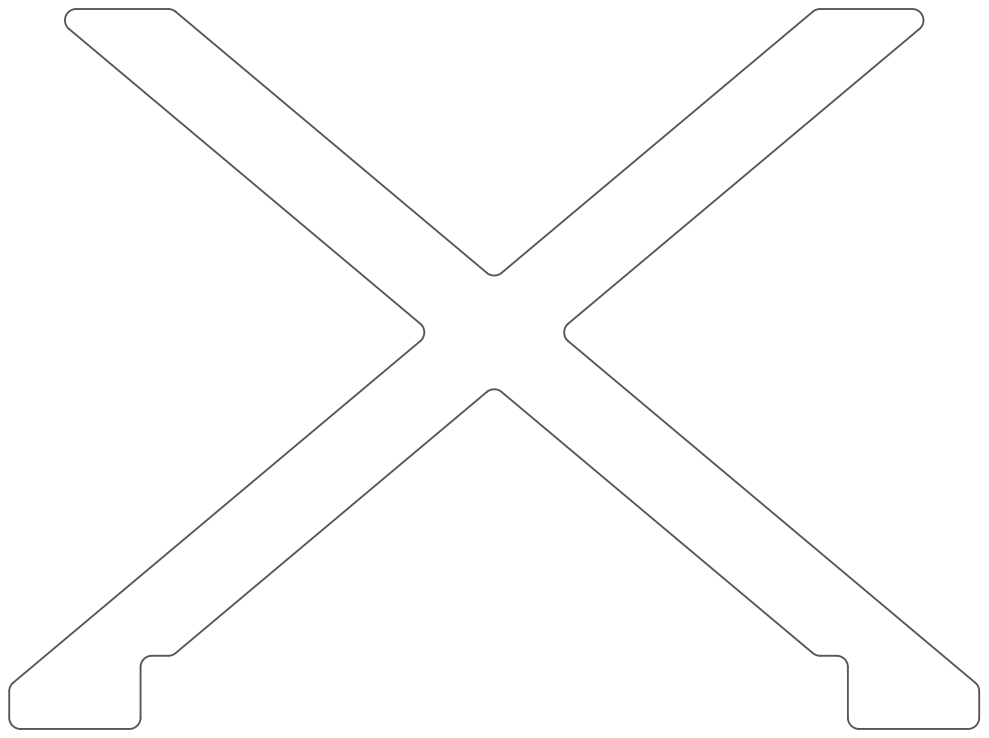
[picture p46: page 3]
D Date: 2025-08-10 Rev: 1; Size: A; Sheet: 3/7 Copper - L2; Engineer: Isaac; Rex; ECAD Version

File: Light Board - X.kicad_pcb Light Board - X

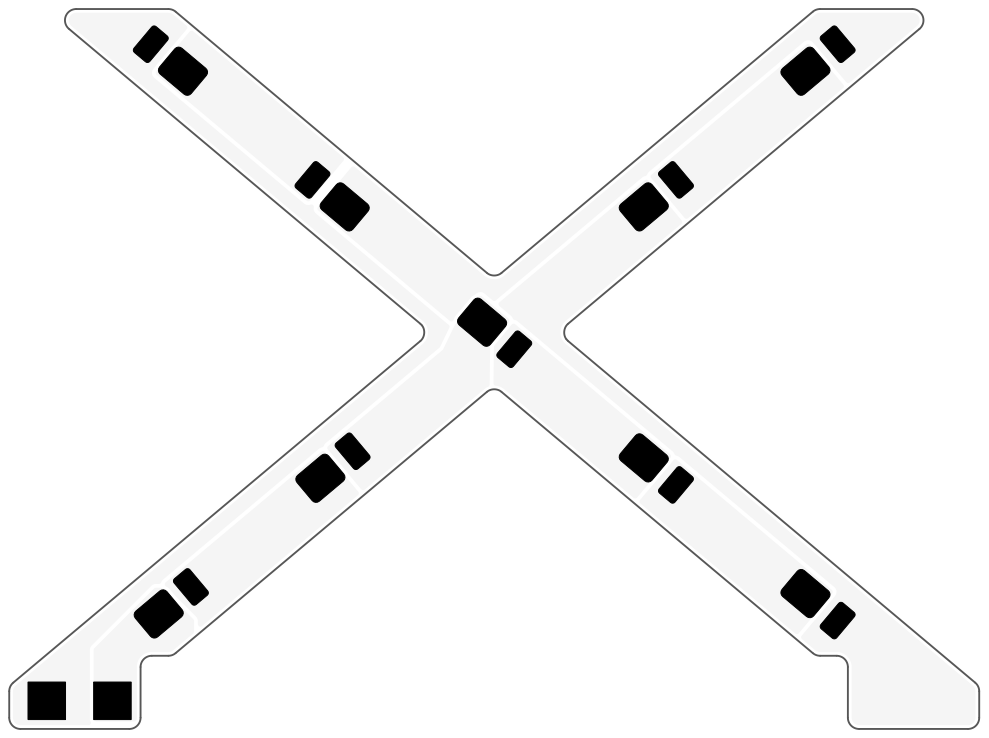
[picture p47: page 4]
D Date: 2025-08-10 Rev: 1; Size: A; Engineer: Isaac; Rex; ECAD Version

File: Light Board - X.kicad_pcb Light Board - X
Sheet: 4/7 Soldermask - Top

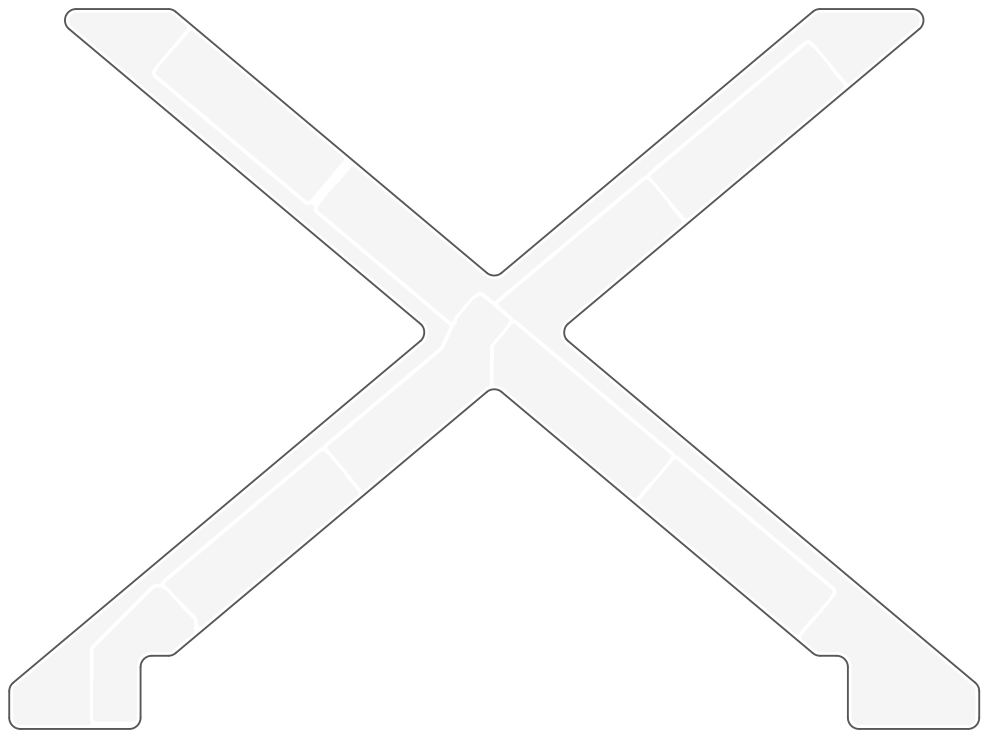
[picture p48: page 5]
D Date: 2025-08-10 Rev: 1; Size: A; Engineer: Isaac; Rex; ECAD Version

File: Light Board - X.kicad_pcb Light Board - X
Sheet: 5/7 Soldermask - Bottom

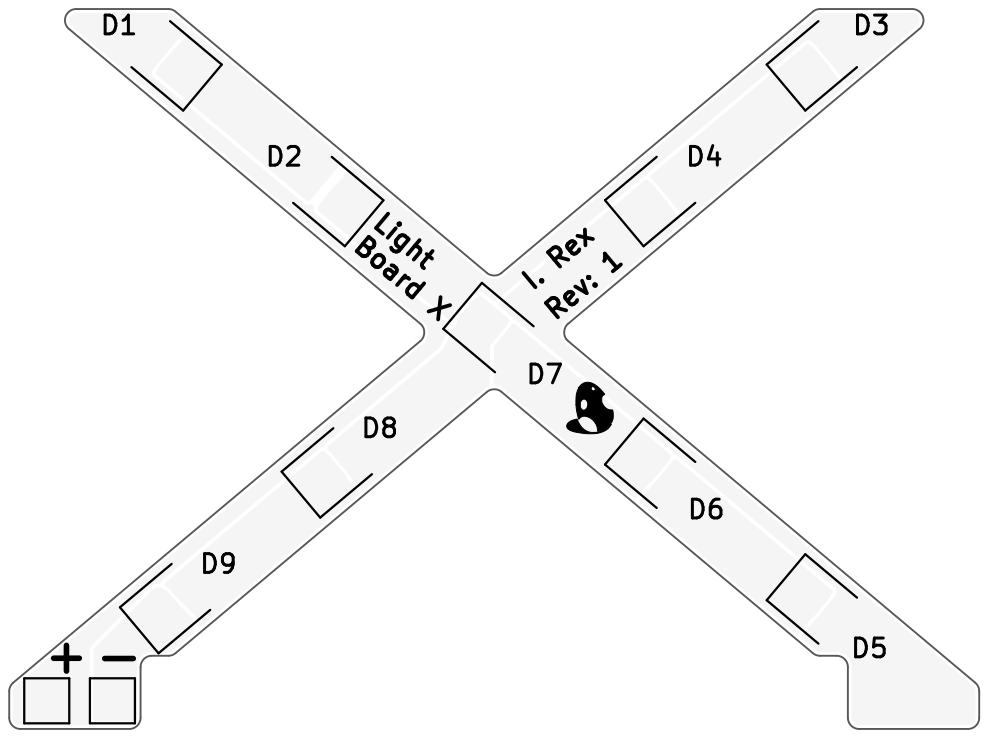
[picture p49: page 6]

File: Light Board - X.kicad_pcb Light Board - X
Sheet: 6/7 Silkscreen - Top

File: Light Board - X.kicad_pcb Light Board - X
Sheet: 7/7 Silk - Bottom
