Acliad/XBOX-Sign/Hardware/Control Board/Release/PDFs/Control Board.pdf

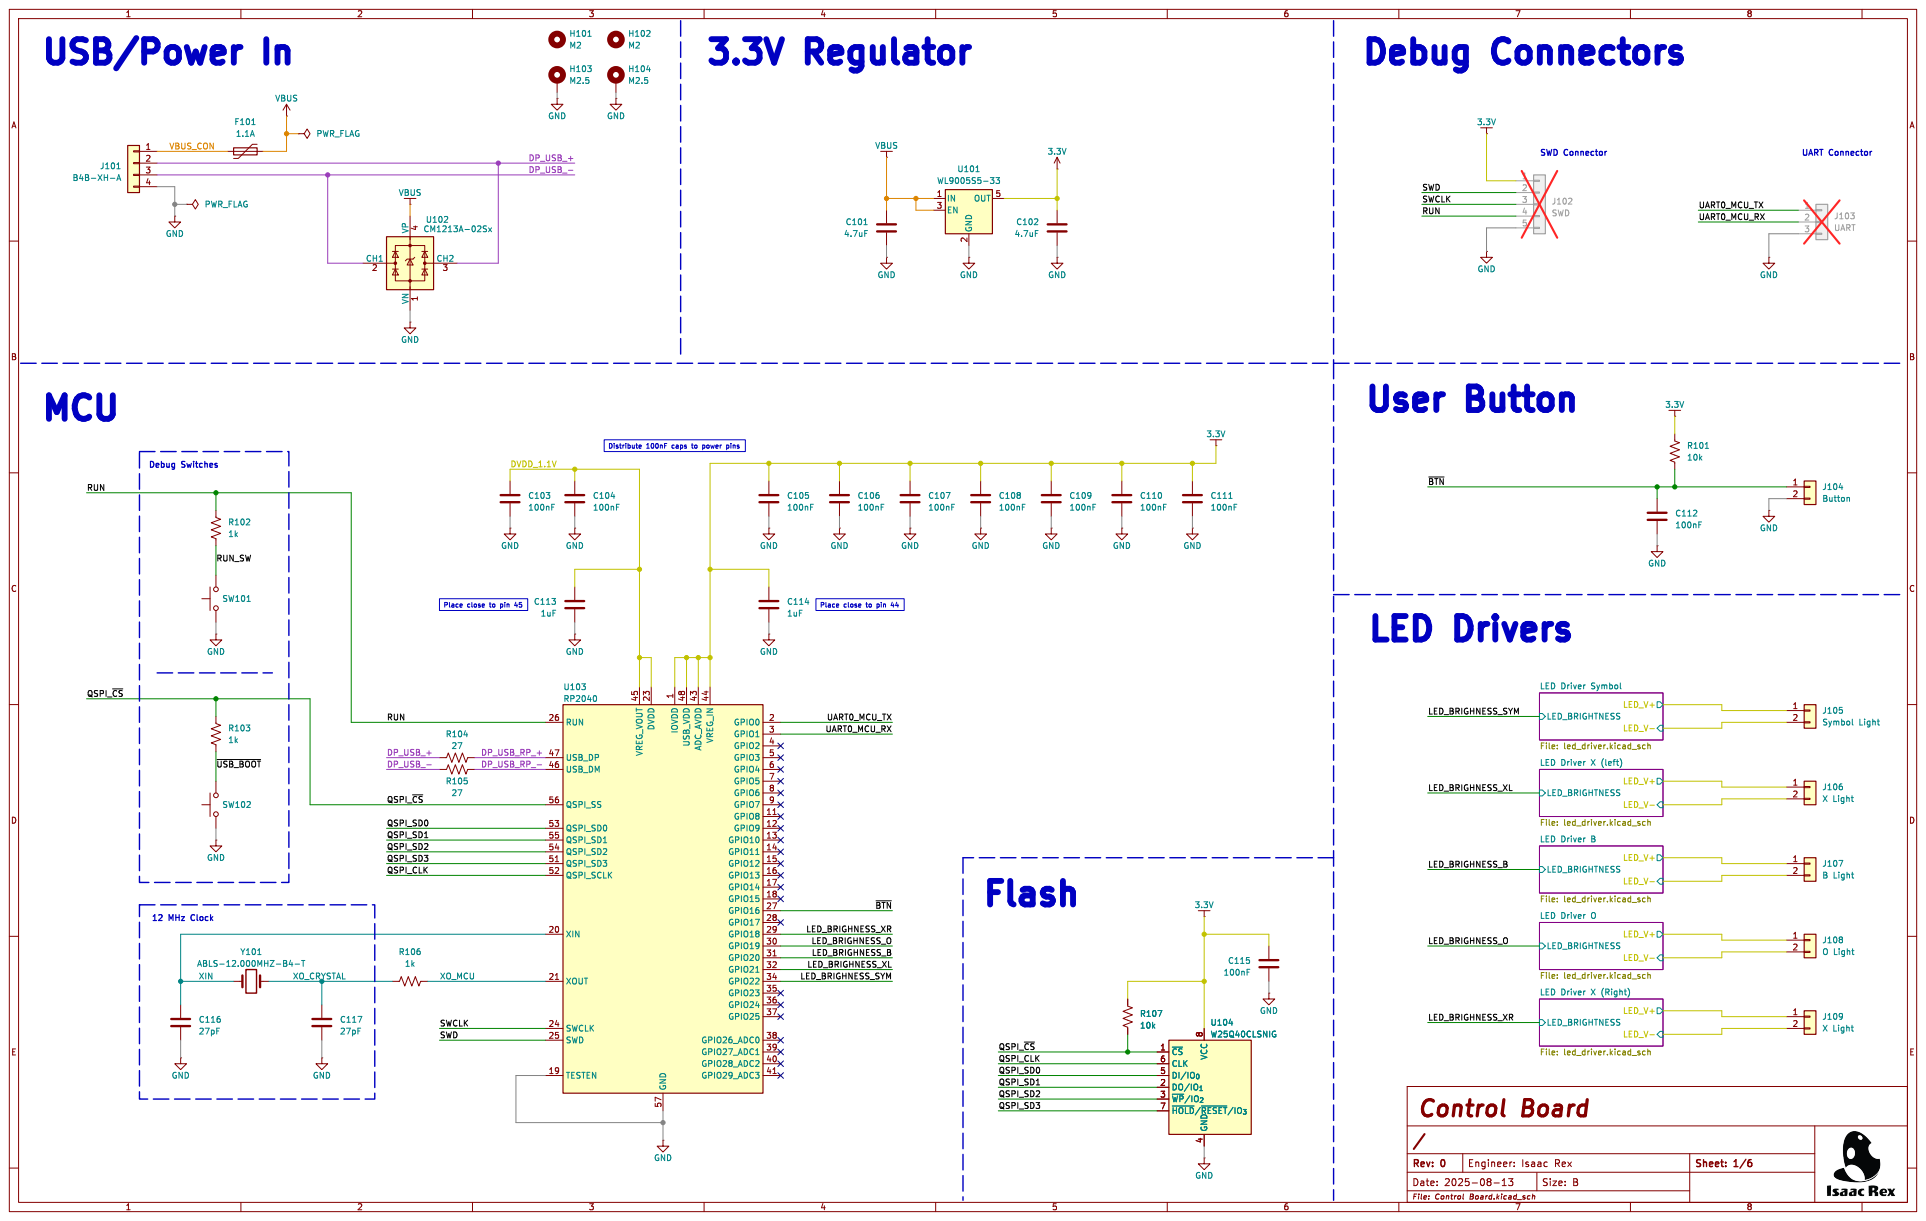
[picture p50: page 1]

LED Driver Symbol File: led_driver.kicad_sch

LED Driver X (left) File: led_driver.kicad_sch

LED Driver X (Right) File: led_driver.kicad_sch

File: Control Board.kicad_sch Control Board

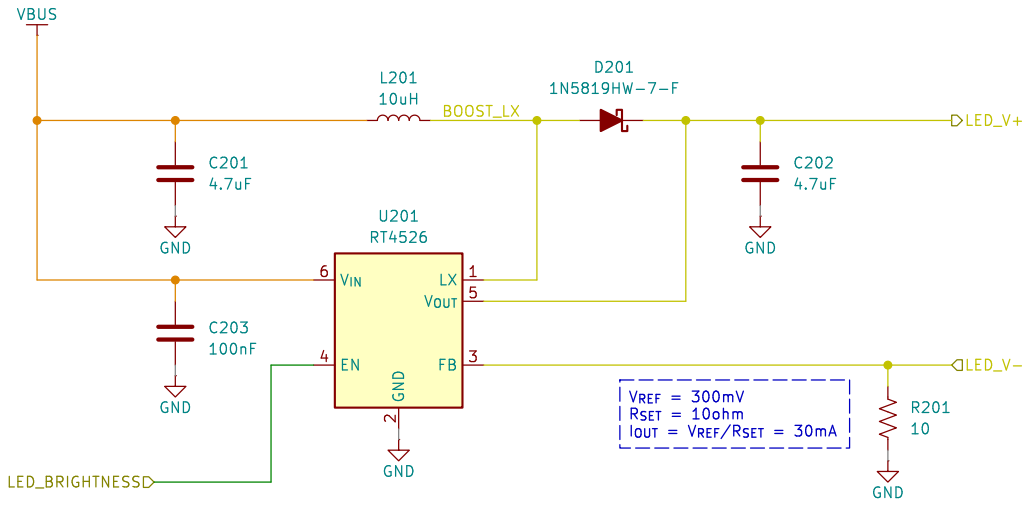
[picture p51: page 2]

/LED Driver Symbol/

Sheet: 2/6

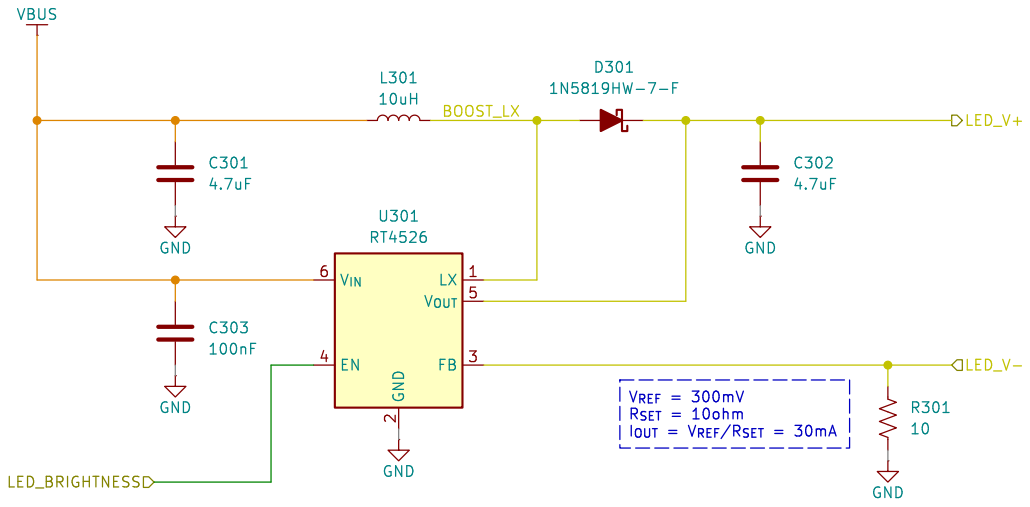
[picture p52: page 3]

/LED Driver X (left)/

Sheet: 3/6

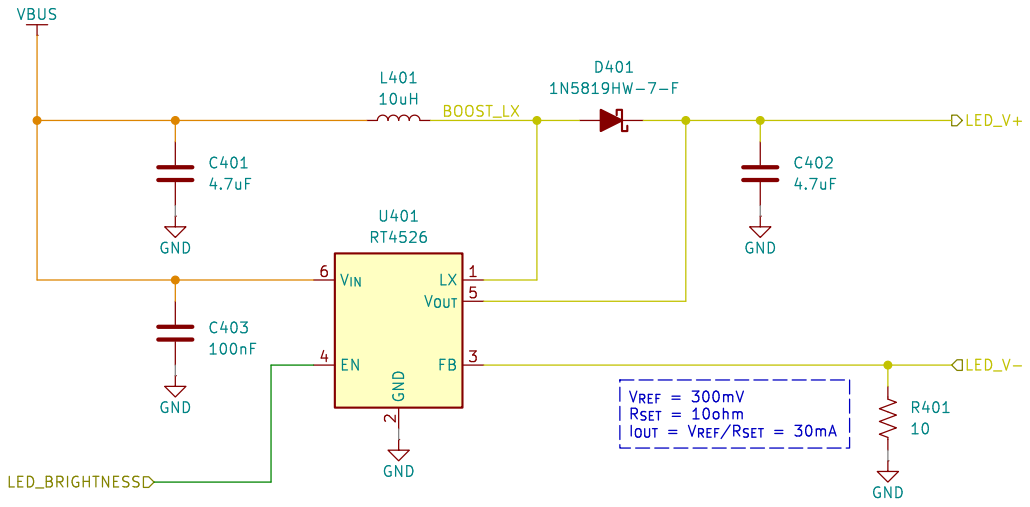
[picture p53: page 4]

/LED Driver B/

Sheet: 4/6

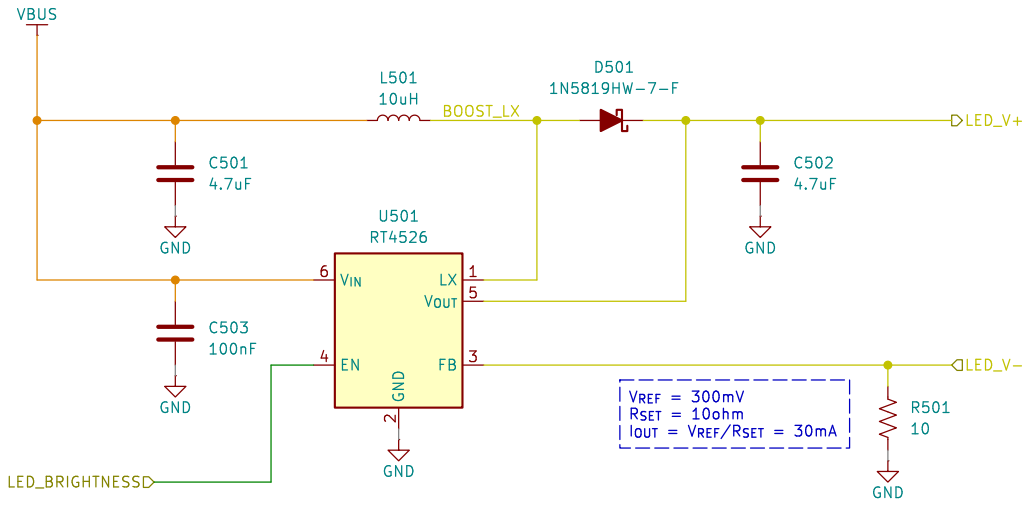
[picture p54: page 5]

/LED Driver O/

Sheet: 5/6

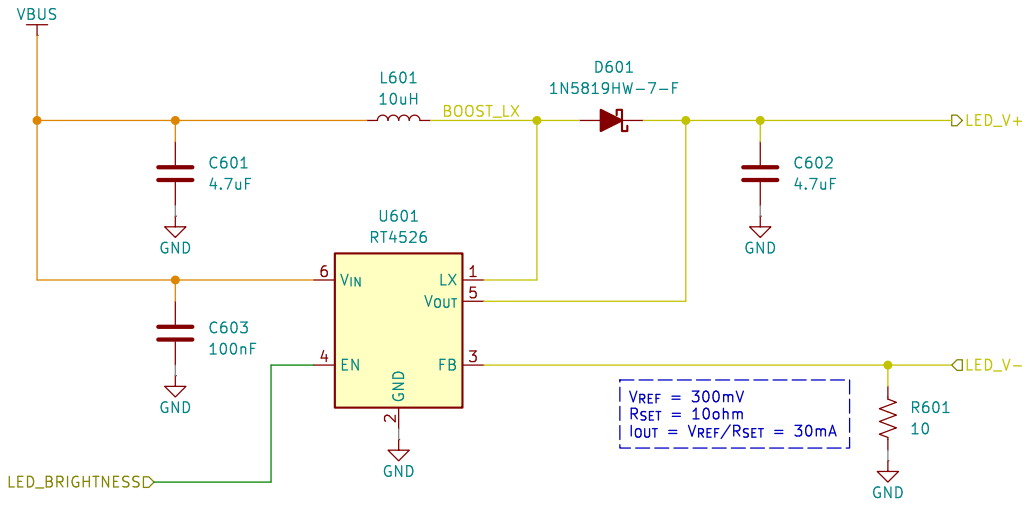
[picture p55: page 6]

/LED Driver X (Right)/

Sheet: 6/6
