Acliad/XBOX-Sign/Hardware/Control Board/Release/PDFs/Control Board_ASY.pdf

1 | 2 | 3 | 4 | 5

A

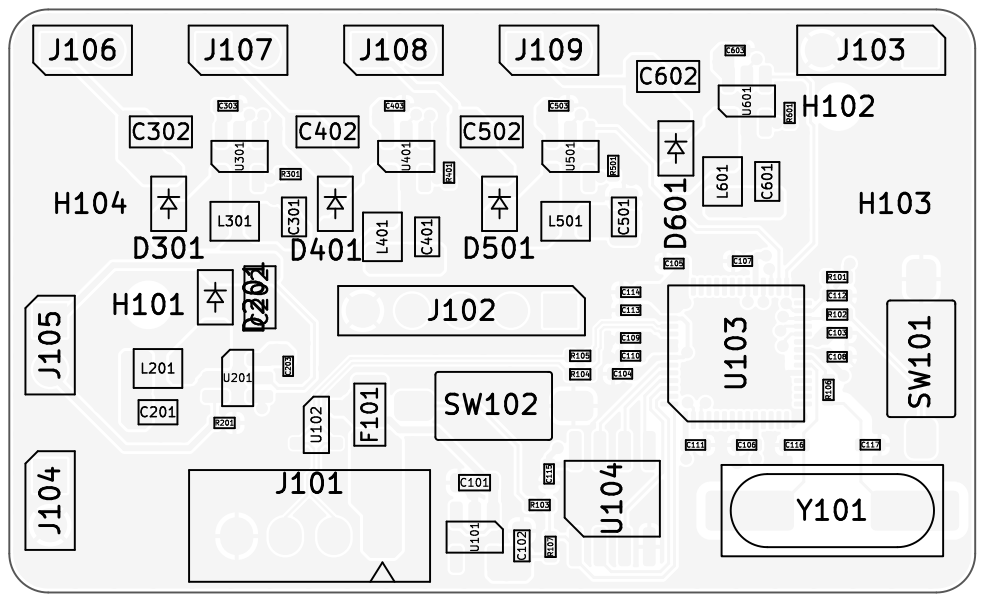
[picture p56: page 1]

File: Control Board.kicad_pcb Control Board

1 | 2 | 3 | 4 | 5

A

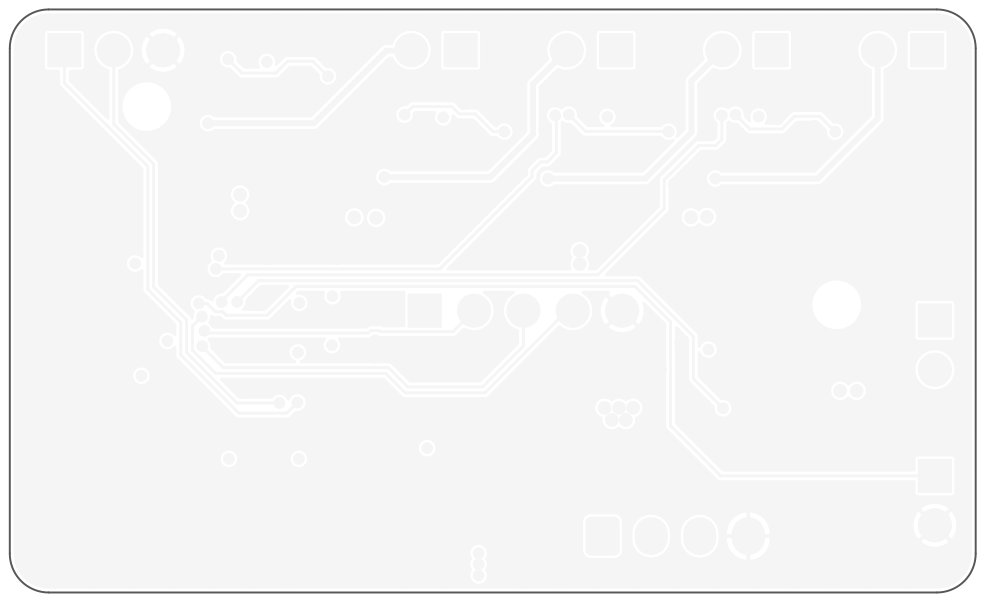
[picture p57: page 2]
D Date: 2025-08-10 Rev: 0; Size: A; Engineer: Isaac; Rex

File: Control Board.kicad_pcb Control Board
Sheet: 2/2 Assembly - Bottom
