Acliad/XBOX-Sign/Hardware/Control Board/Release/PDFs/Control Board_FAB.pdf

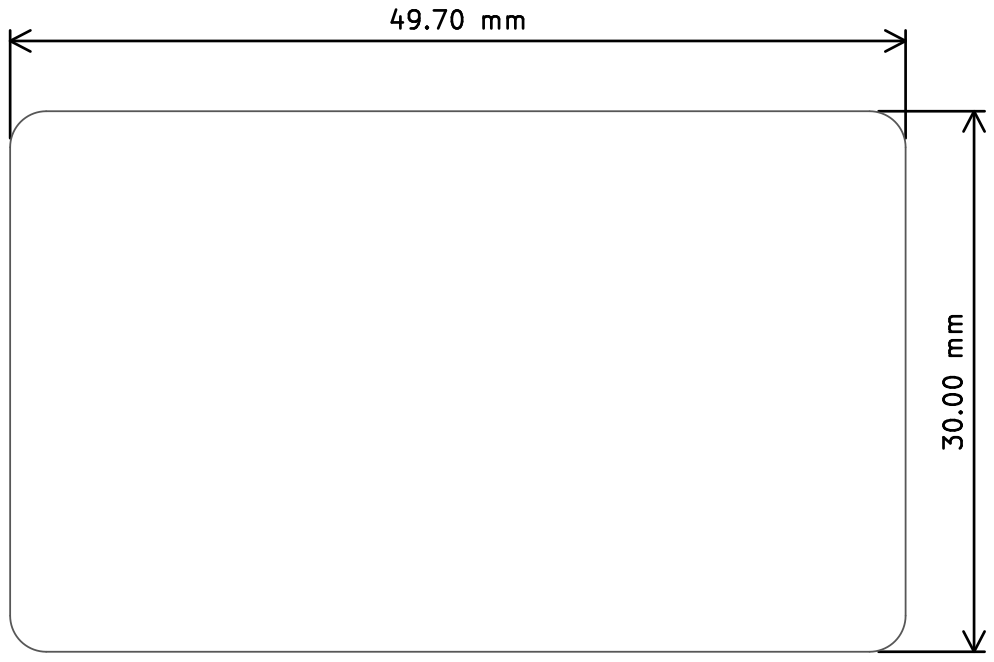
[picture p58: page 1]
D Date: 2025-08-10 Rev: 0; Size: A; Sheet:; 1/9 Fab Drawing; Engineer: Isaac; Rex ³⁰.00 mm

File: Control Board.kicad_pcb Control Board

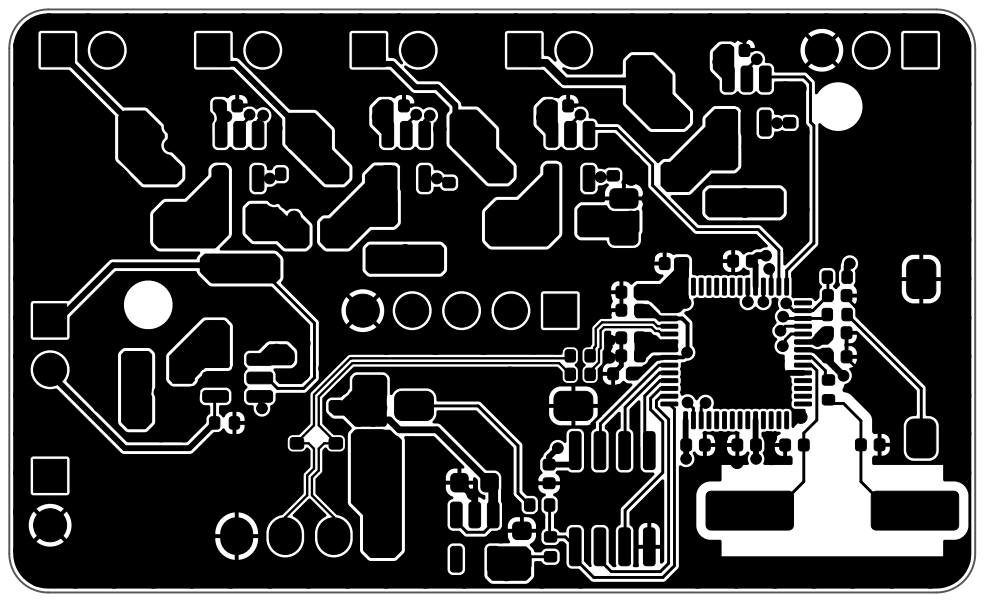
[picture p59: page 2]
D Date: 2025-08-10 Rev: 0; Size: A; Sheet: 2/9 Copper - L1; Engineer: Isaac; Rex

File: Control Board.kicad_pcb Control Board

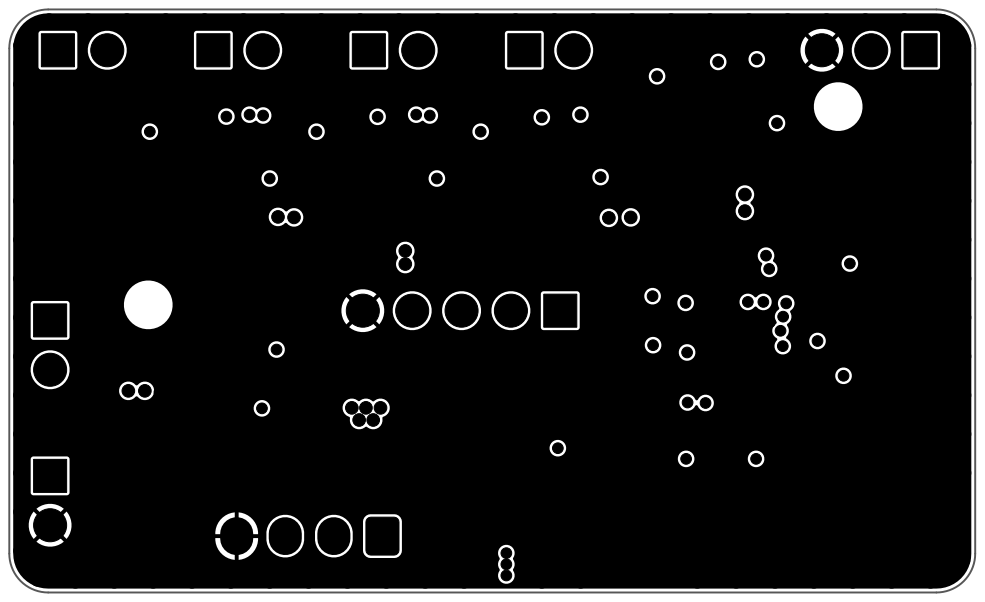
[picture p60: page 3]
D Date: 2025-08-10 Rev: 0; Size: A; Sheet: 3/9 Copper - L2; Engineer: Isaac; Rex

File: Control Board.kicad_pcb Control Board

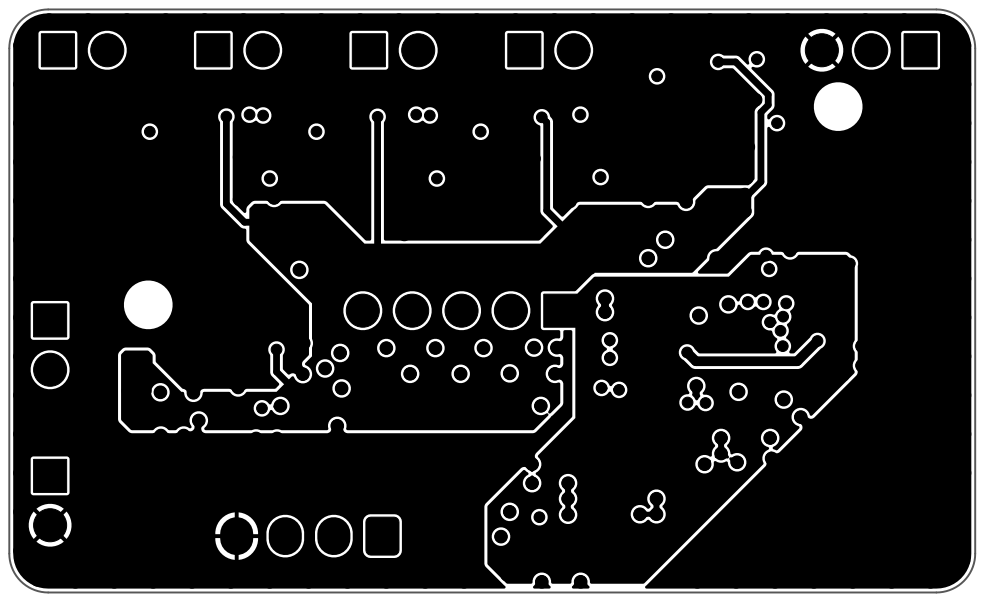
[picture p61: page 4]
D Date: 2025-08-10 Rev: 0; Size: A; Sheet: 4/9 Copper - L3; Engineer: Isaac; Rex

File: Control Board.kicad_pcb Control Board

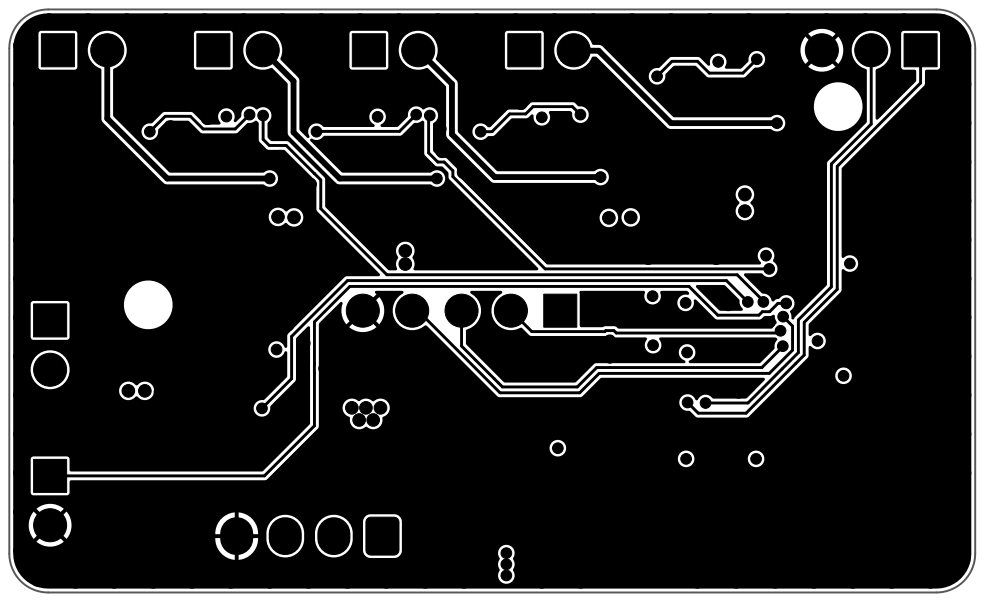
[picture p62: page 5]
D Date: 2025-08-10 Rev: 0; Size: A; Sheet: 5/9 Copper - L4; Engineer: Isaac; Rex

File: Control Board.kicad_pcb Control Board

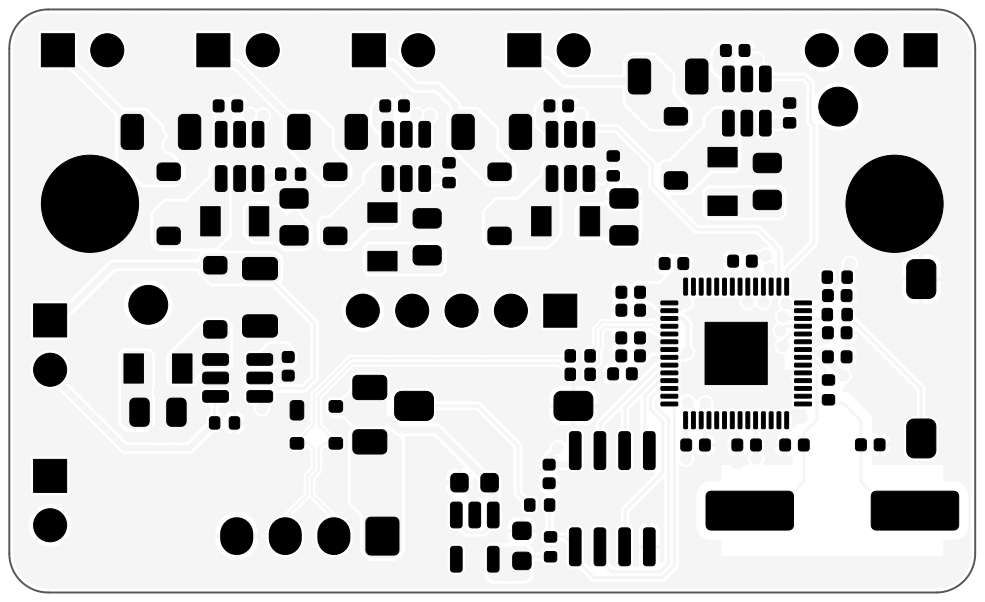
[picture p63: page 6]
D Date: 2025-08-10 Rev: 0; Size: A; Engineer: Isaac; Rex

File: Control Board.kicad_pcb Control Board
Sheet: 6/9 Soldermask - Top

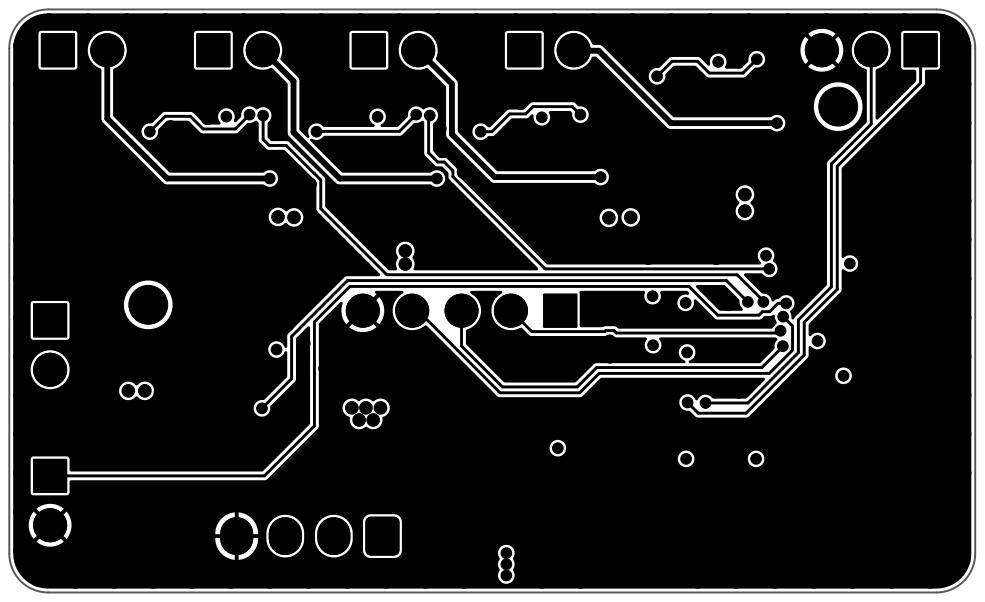
[picture p64: page 7]
D Date: 2025-08-10 Rev: 0; Size: A; Engineer: Isaac; Rex

File: Control Board.kicad_pcb Control Board
Sheet: 7/9 Soldermask - Bottom

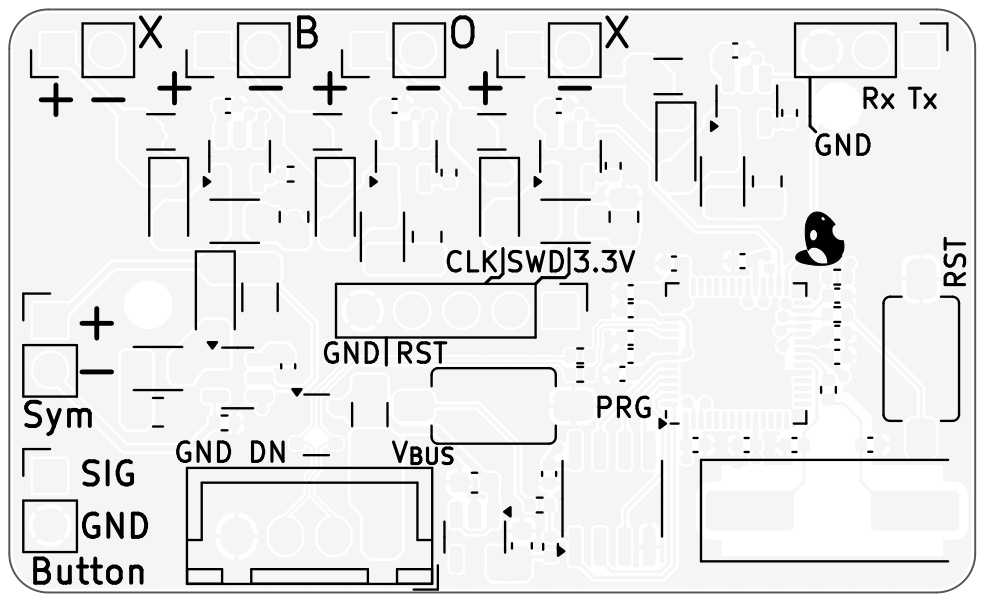
[picture p65: page 8]
D Date: 2025-08-10 Rev: 0; Size: A; Engineer: Isaac; Rex; RST -; PRG; 3.3V GND; V_{BUS} +; CLK +; GND; Rx RST GND; Button Sym; SIG; SWD B

File: Control Board.kicad_pcb Control Board
Sheet: 8/9 Silkscreen - Top

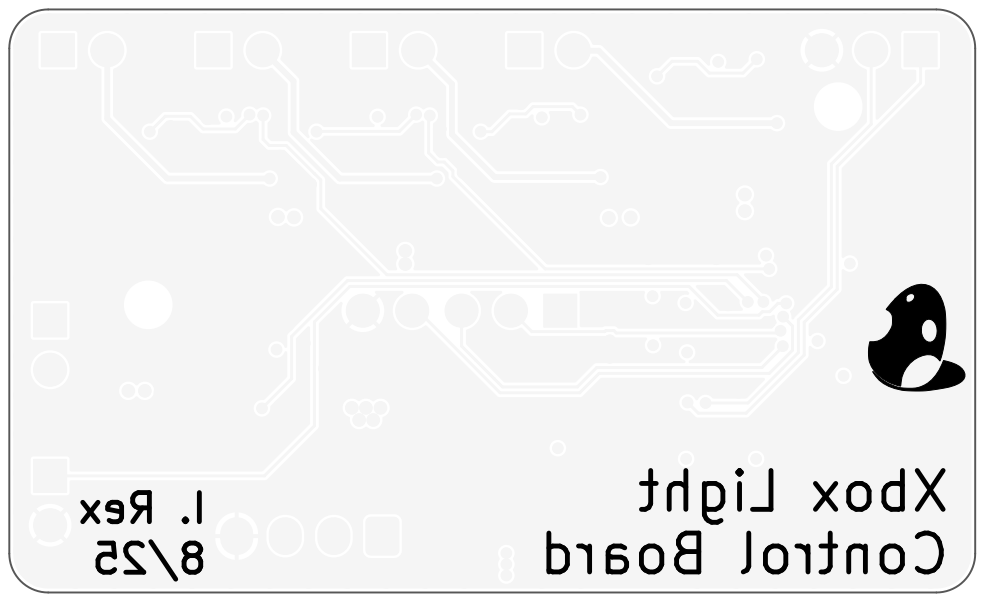
[picture p66: page 9]
D Date: 2025-08-10 Rev: 0; Size: A; Engineer: Isaac; Rex

File: Control Board.kicad_pcb Control Board
Sheet: 9/9 Silk - Bottom
