Acliad/XBOX-Sign/Hardware/USB-C Board/Release/PDFs/USB-C Board.pdf

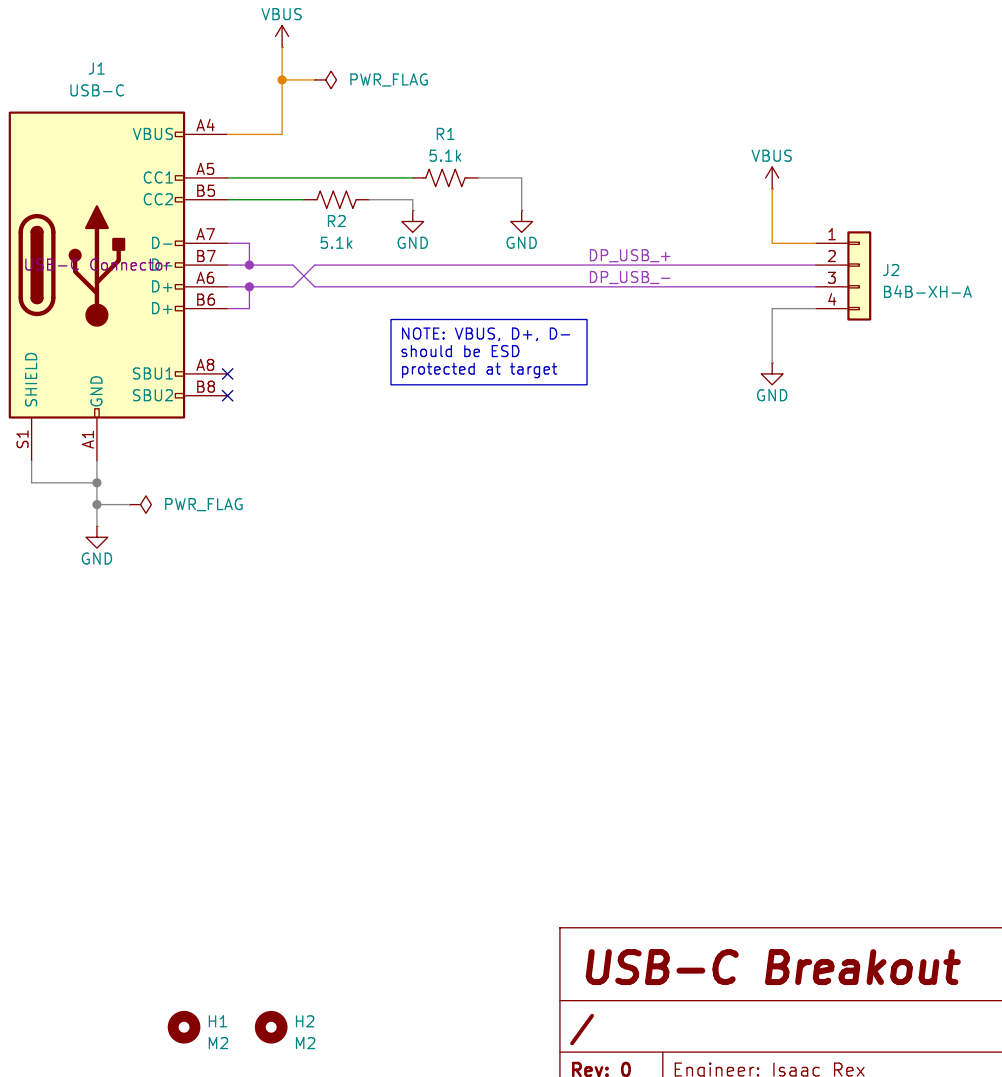
[picture p67: page 1]

J2B4B-XH-A DP_USB_- DP_USB_+ NOTE: VBUS, D+, D- should be ESD

File: USB-C Board.kicad_sch USB-C Breakout
