Acliad/XBOX-Sign/Hardware/USB-C Board/Release/PDFs/USB-C Board_ASY.pdf

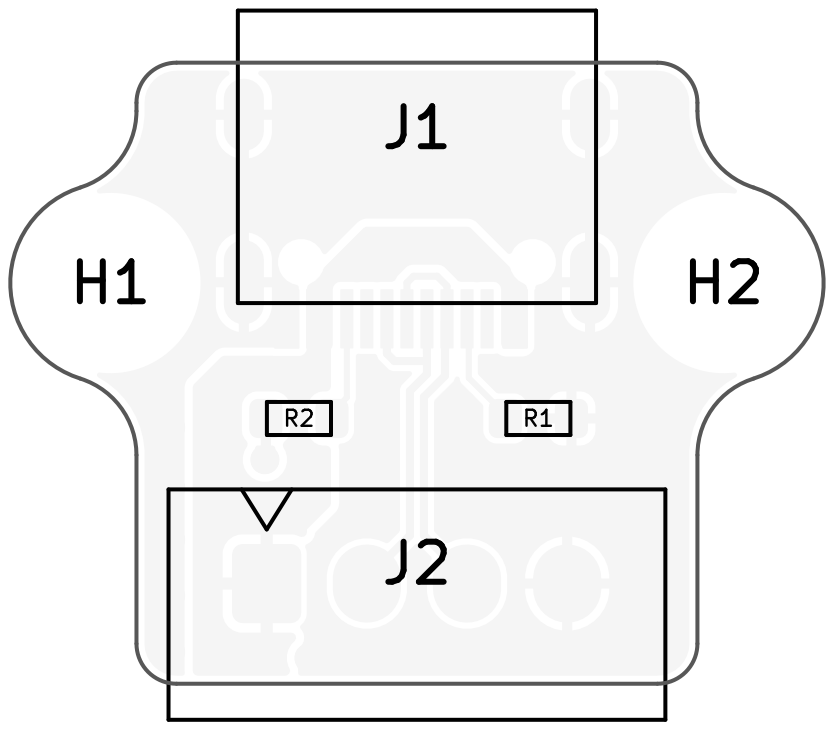
[picture p68: page 1]
D Date: 2023-03-13 Rev: 0; Size: A; Engineer: Isaac; Rex

File: USB-C Board.kicad_pcb USB-C Breakout
Sheet: /1 Assembly - Top

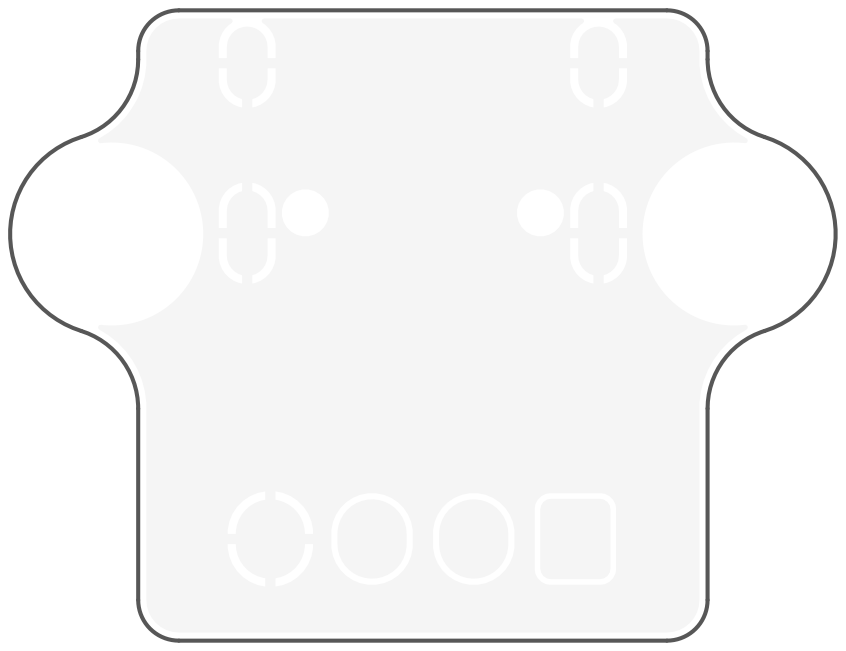
[picture p69: page 2]
D Date: 2023-03-13 Rev: 0; Size: A; Engineer: Isaac; Rex

File: USB-C Board.kicad_pcb USB-C Breakout
Sheet: /1 Assembly - Bottom
