Acliad/XBOX-Sign/Hardware/USB-C Board/Release/PDFs/USB-C Board_FAB.pdf

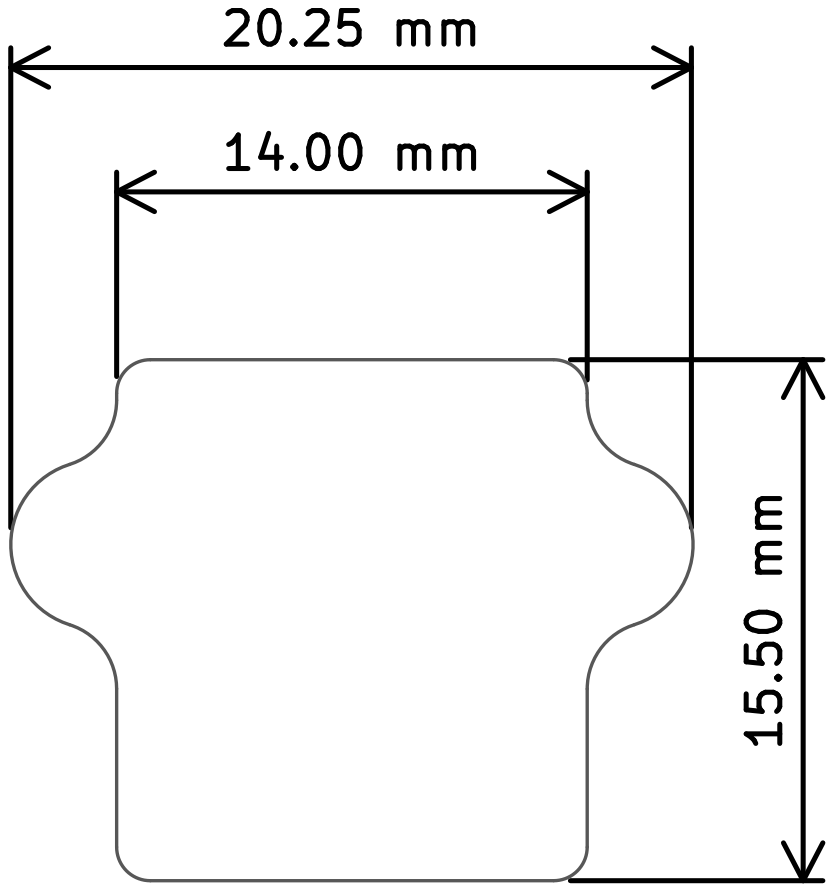
[picture p70: page 1]
D Date: 2023-03-13 Rev: 0; Size: A; Engineer: Isaac; Rex

File: USB-C Board.kicad_pcb USB-C Breakout
Sheet: /1 Fab Drawing

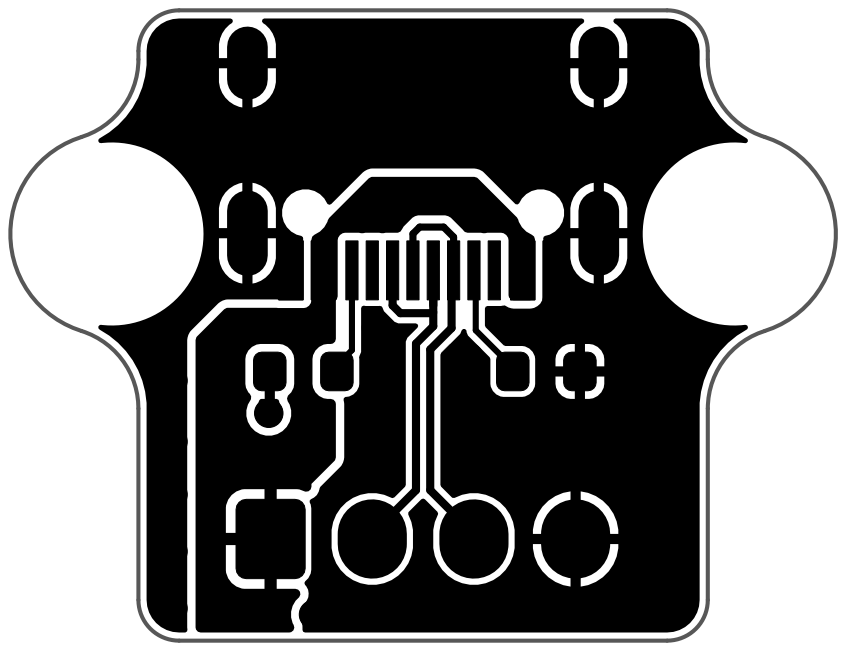
[picture p71: page 2]
D Date: 2023-03-13 Rev: 0; Size: A; Engineer: Isaac; Rex

File: USB-C Board.kicad_pcb USB-C Breakout
Sheet: /1 Copper - L1

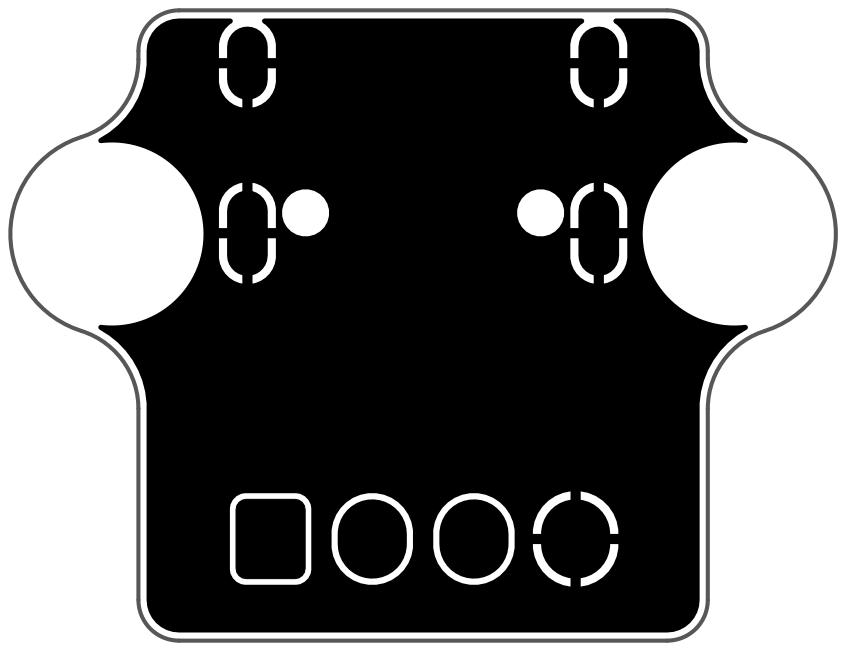
[picture p72: page 3]
D Date: 2023-03-13 Rev: 0; Size: A; Engineer: Isaac; Rex

File: USB-C Board.kicad_pcb USB-C Breakout
Sheet: /1 Copper - L2

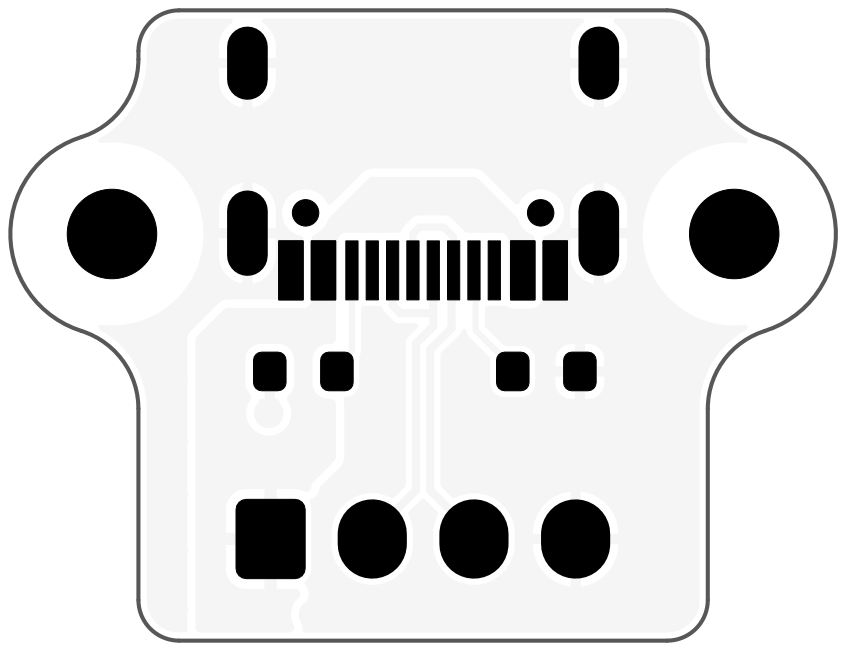
[picture p73: page 4]
D Date: 2023-03-13 Rev: 0; Size: A; Engineer: Isaac; Rex

File: USB-C Board.kicad_pcb USB-C Breakout
Sheet: /1 Soldermask - Top

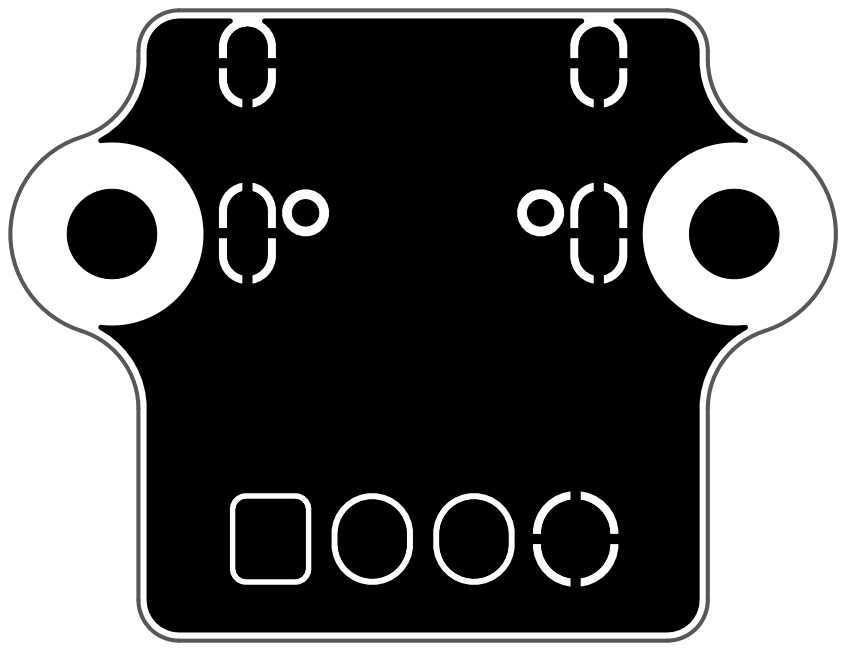
[picture p74: page 5]
D Date: 2023-03-13 Rev: 0; Size: A; Engineer: Isaac; Rex

File: USB-C Board.kicad_pcb USB-C Breakout
Sheet: /1 Soldermask - Bottom

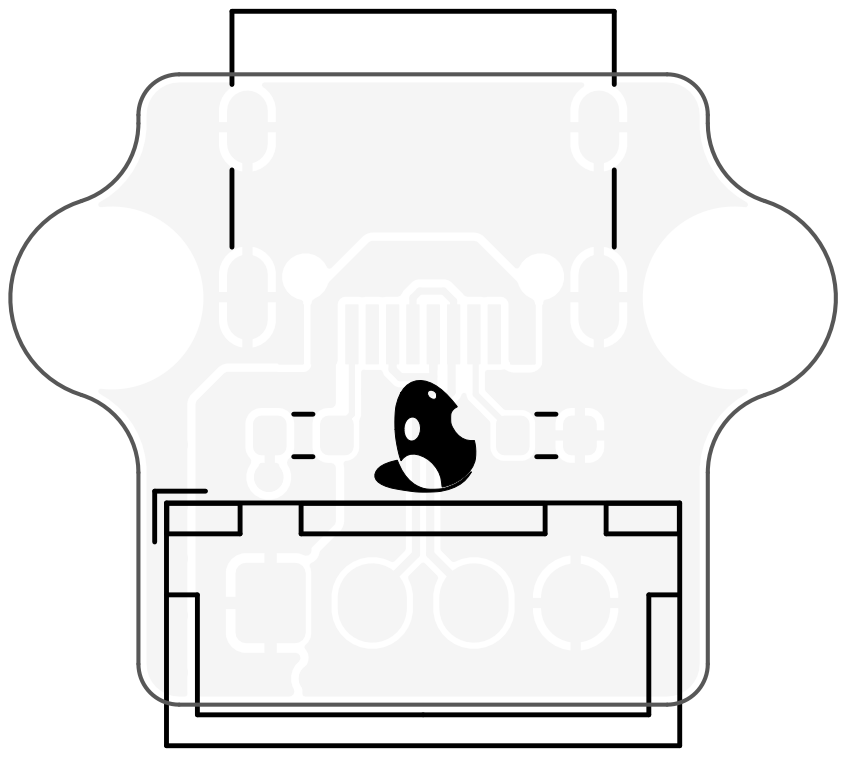
[picture p75: page 6]
D Date: 2023-03-13 Rev: 0; Size: A; Engineer: Isaac; Rex

File: USB-C Board.kicad_pcb USB-C Breakout
Sheet: /1 Silkscreen - Top

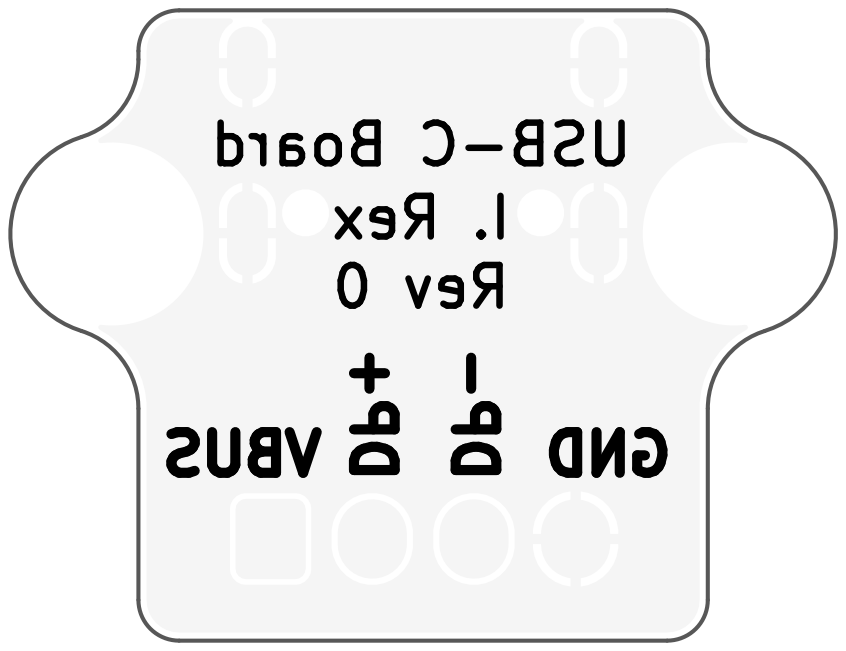
[picture p76: page 7]
D Date: 2023-03-13 Rev: 0; Size: A; Engineer: Isaac; Rex

File: USB-C Board.kicad_pcb USB-C Breakout
Sheet: /1 Silk - Bottom
