Acliad/XBOX-Sign/Hardware/Light Board - Symbol/Light Board - Symbol.kicad_pcb

## KiCad design Hardware/Light Board - Symbol/Light Board - Symbol.kicad_pcb (2025-08-30)

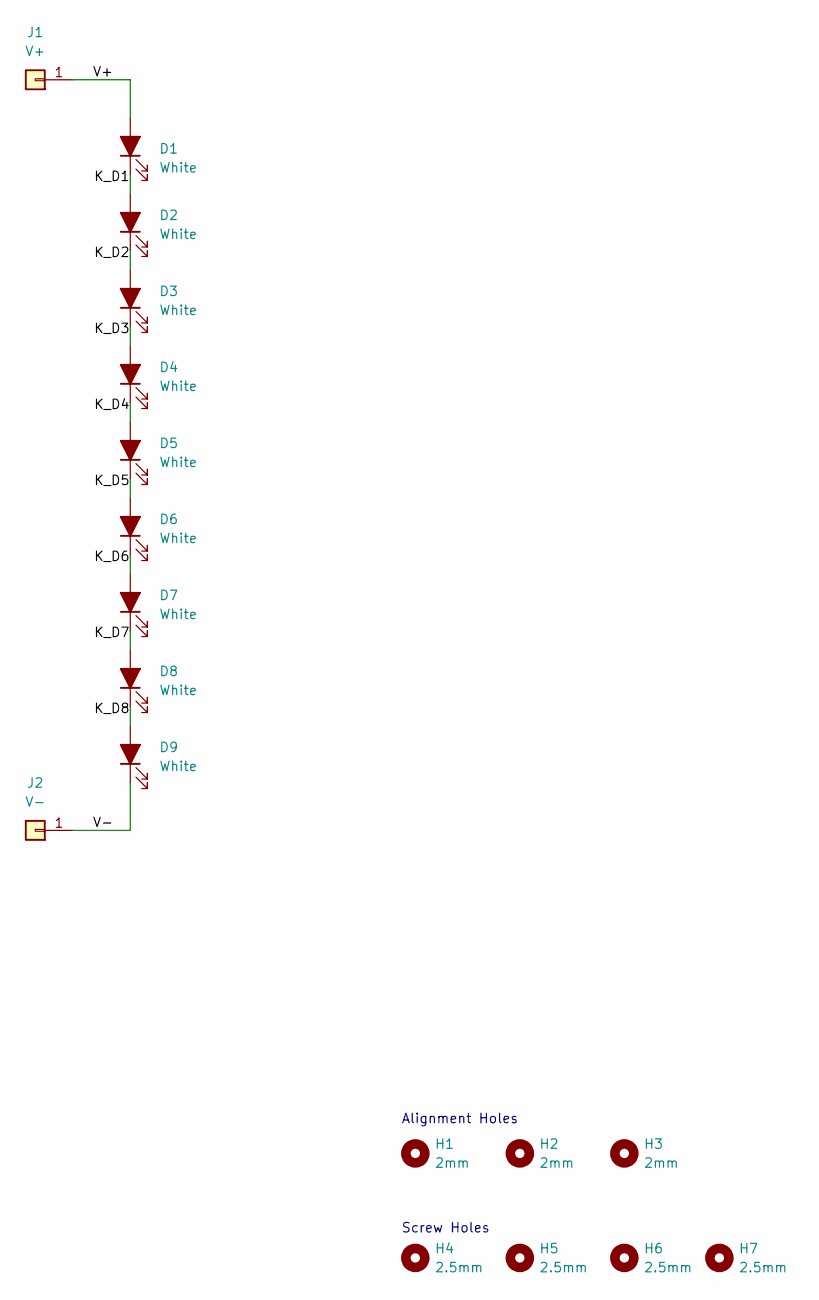
[picture p77: schematic Light Board - Symbol.kicad_sch, ${PROJECTNAME}]

Parts:
D1, D2, D3, D4, D5, D6, D7, D8, D9: White; LED_Cree_J-Series_SMD2835_2.8x3.5mm; MPN JB2835AWT-W-H40GA0000-N0000001; DigiKey PN 2138-JB2835AWT-W-H40GA0000-N0000001CT-ND
H1, H2, H3: 2mm; MountingHole_2.0mm_M2_ReducedCourtyard
H4, H5, H6, H7: 2.5mm; MountingHole_2.5mm
J1: V+; TestPoint_Pad_2.0x2.0mm
J2: V-; TestPoint_Pad_2.0x2.0mm

Connections:
/K_D1: D1.1 (K), D2.2 (A)
/K_D2: D2.1 (K), D3.2 (A)
/K_D3: D3.1 (K), D4.2 (A)
/K_D4: D4.1 (K), D5.2 (A)
/K_D5: D5.1 (K), D6.2 (A)
/K_D6: D6.1 (K), D7.2 (A)
/K_D7: D7.1 (K), D8.2 (A)
/K_D8: D8.1 (K), D9.2 (A)
/V+: D1.2 (A), J1.1
/V-: D9.1 (K), J2.1

Notes on the sheet:
Alignment Holes
Screw Holes

Board: 2 copper layers, 18 parts (0 on the bottom side), 10 nets, no tracks yet.
