Acliad/XBOX-Sign/Hardware/Control Board/Control Board.kicad_pcb

## KiCad design Hardware/Control Board/Control Board.kicad_pcb (2025-08-16)

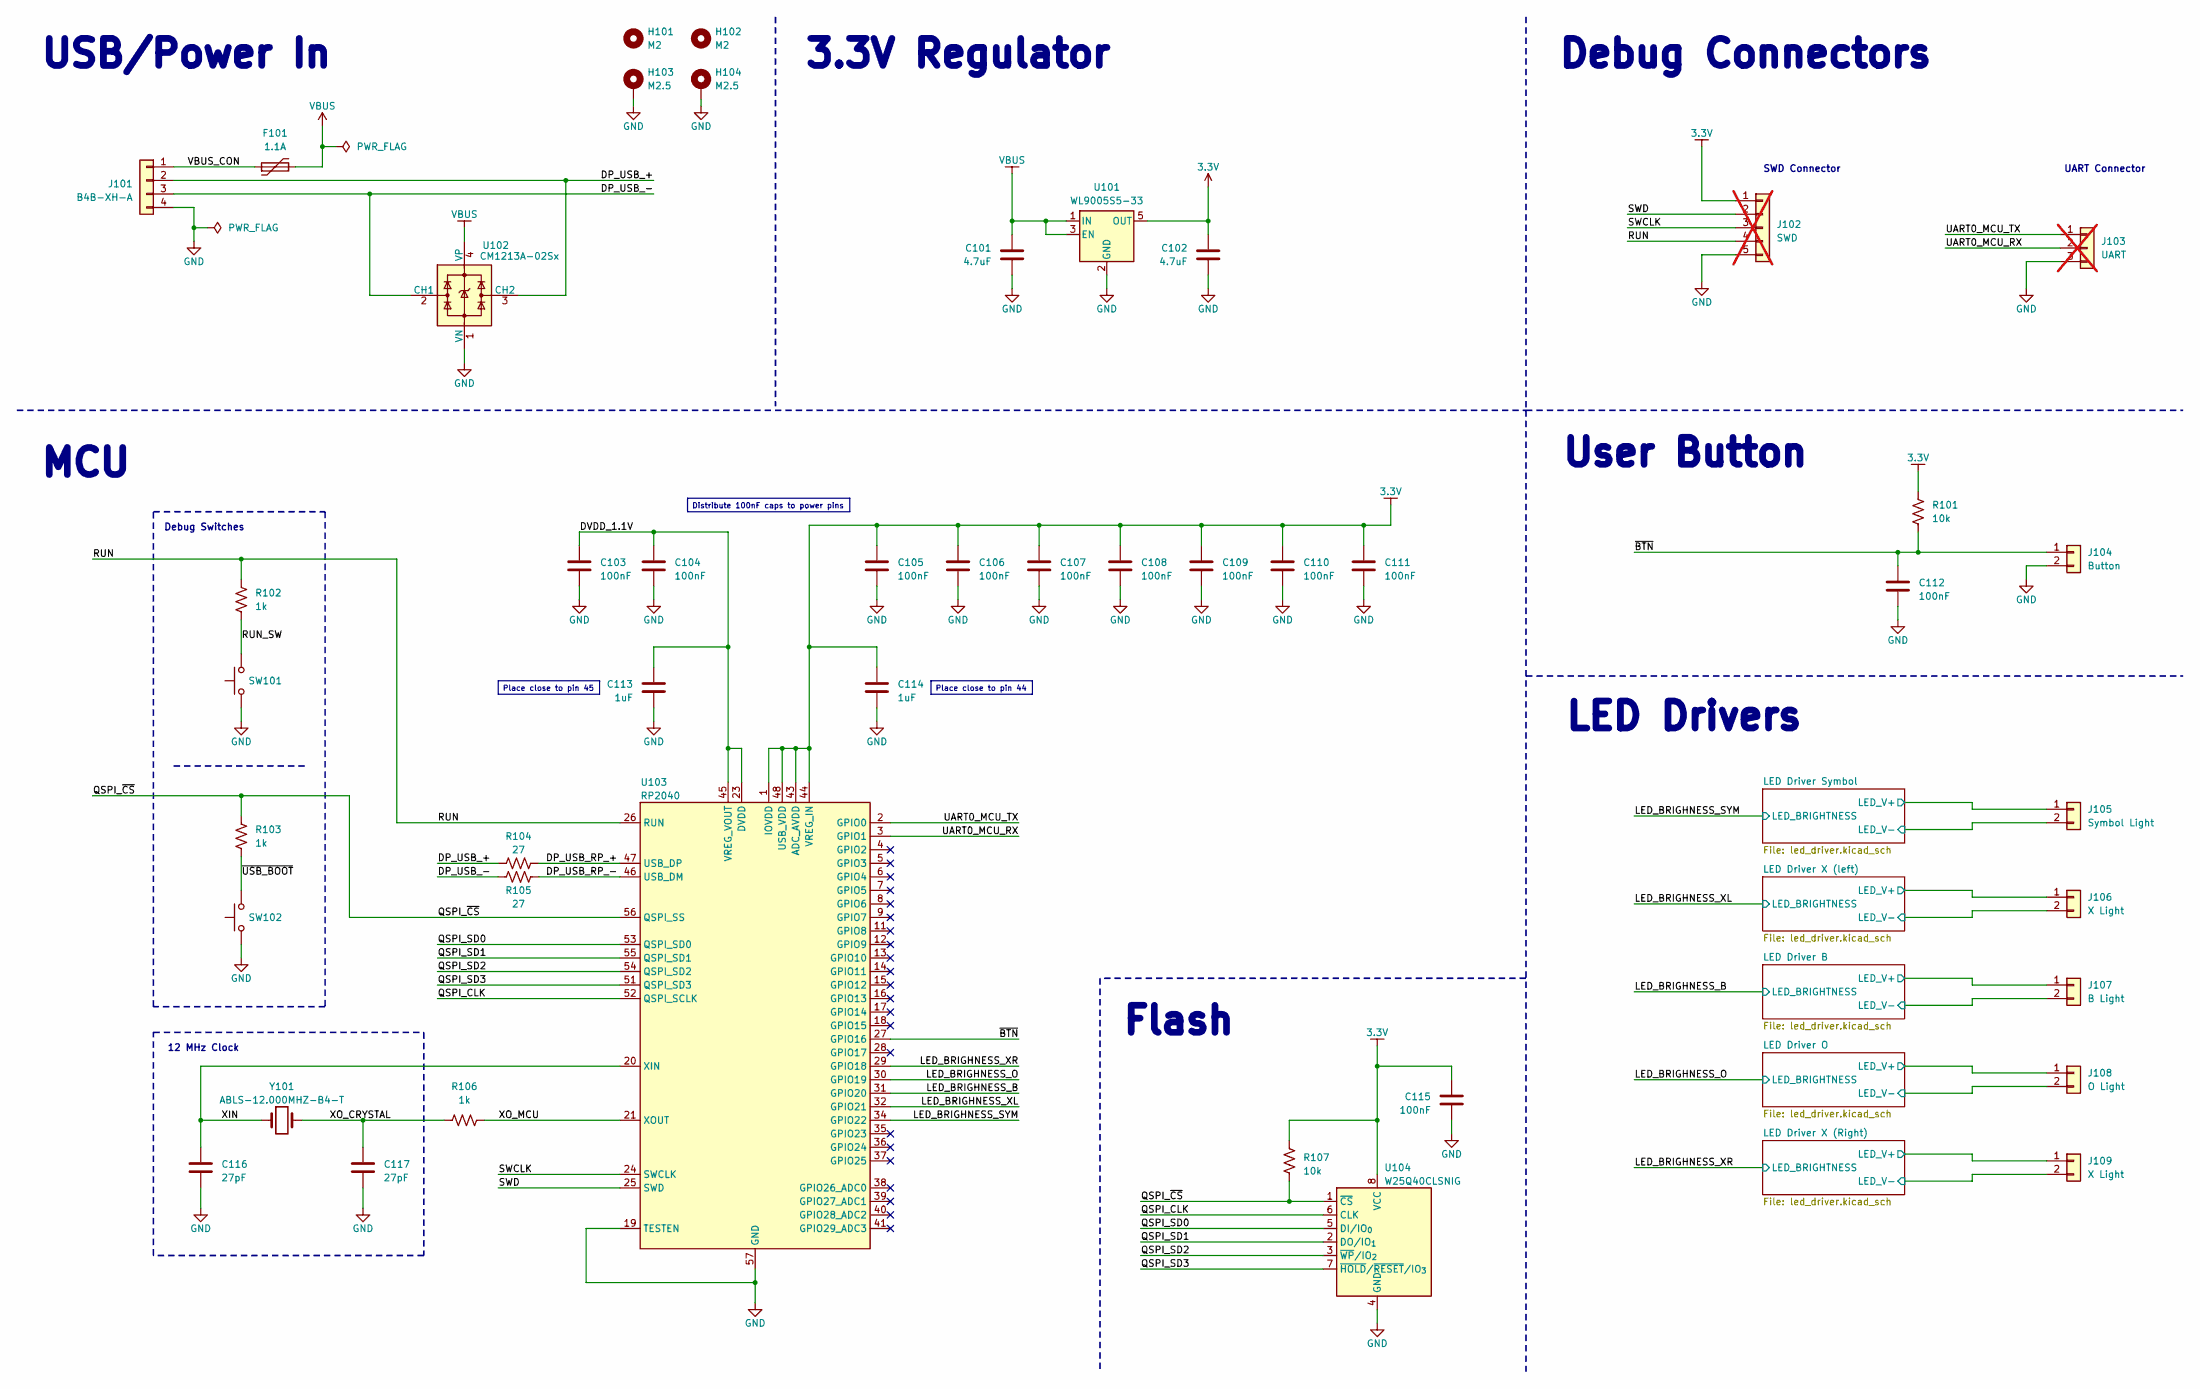
[picture p78: schematic Control Board.kicad_sch, ${PROJECTNAME}]

Parts:
C101, C102: 4.7uF; C_0603_1608Metric; MPN CL10A475KP8NNNC; LCSC PN C1705
C103, C104, C105, C106, C107, C108, C109, C110, C111, C112, C115: 100nF; C_0402_1005Metric; MPN CL05B104KO5NNNC; DigiKey PN 1276-1006-1-ND
C113, C114: 1uF; C_0402_1005Metric; MPN CL05A105KA5NQNC; DigiKey PN 1276-6524-1-ND
C116, C117: 27pF; C_0402_1005Metric; MPN CC0402FRNPO9BN270; DigiKey PN 1276-2247-1-ND
F101: 1.1A; Fuse_1206_3216Metric; MPN NANOSMDC050F/13.2-2; LCSC PN C2649911
H101, H102: M2; MountingHole_2.0mm_M2_ReducedCourtyard
H103, H104: M2.5; MountingHole_2.5mm_Pad
J101: B4B-XH-A; JST_XH_B4B-XH-A_1x04_P2.50mm_Vertical; MPN B4B-XH-A; DigiKey PN 455-2237-ND
J102: SWD; PinHeader_1x05_P2.54mm_Vertical; MPN PZ254V-11-05P; DigiKey PN 2057-PH1-05-UA-ND; not fitted
J103: UART; PinHeader_1x03_P2.54mm_Vertical; MPN PZ254V-11-03P; LCSC PN C2937625; not fitted
J104: Button; PinHeader_1x02_P2.54mm_Vertical
J105: Symbol Light; PinHeader_1x02_P2.54mm_Vertical
J106, J109: X Light; PinHeader_1x02_P2.54mm_Vertical
J107: B Light; PinHeader_1x02_P2.54mm_Vertical
J108: O Light; PinHeader_1x02_P2.54mm_Vertical
R101: 10k; R_0402_1005Metric; MPN RC0402FR-0710KL; DigiKey PN CR0603-FX-27R0ELFCT-ND
R102, R103, R106: 1k; R_0402_1005Metric; MPN RC0402FR-071KL; DigiKey PN RNCP0603FTD1K00CT-ND
R104, R105: 27; R_0402_1005Metric; MPN RC0402FR-0727RL; DigiKey PN CR0603-FX-27R0ELFCT-ND
R107: 10k; R_0402_1005Metric; MPN RC0402FR-0710KL; DigiKey PN RNCP0603FTD1K00CT-ND
SW101, SW102: PTS636 SL43 SMTR LFS; SW-PUSH-6x3.5mm_CK-PTS636SL43x_HandSolder; MPN PTS636 SL43 SMTR LFS; DigiKey PN CKN12309-1-ND
U101: WL9005S5-33; SOT-23-5; MPN WL9005S5-33; LCSC PN C2688249
U102: CM1213A−02Sx; SOT-143; MPN CM1213A-02SR; LCSC PN C19268160
U103: RP2040; QFN-56-1EP_7x7mm_P0.4mm_EP3.2x3.2mm; MPN RP2040; DigiKey PN 2648-SC0914(13)CT-ND
U104: W25Q40CLSNIG; SOIC-8_3.9x4.9mm_P1.27mm; MPN W25Q40CLSNIG; DigiKey PN W25Q40CLSNIG-ND
Y101: ABLS-12.000MHZ-B4-T; Crystal_SMD_HC49-SD; MPN ABLS-12.000MHZ-B4-T; DigiKey PN 535-10218-1-ND

Connections:
3.3V: C102.1, C105.1, C106.1, C107.1, C108.1, C109.1, C110.1, C111.1, C114.1, C115.1, J102.1, R101.2, R107.1, U101.5 (OUT), U103.1 (IOVDD), U103.10 (IOVDD), U103.22 (IOVDD), U103.33 (IOVDD), U103.42 (IOVDD), U103.43 (ADC_AVDD), U103.44 (VREG_IN), U103.48 (USB_VDD), U103.49 (IOVDD), U104.8 (VCC)
/DP_USB_+: J101.2, R104.1, U102.3 (CH2)
/DP_USB_-: J101.3, R105.1, U102.2 (CH1)
/DP_USB_RP_+: R104.2, U103.47 (USB_DP)
/DP_USB_RP_-: R105.2, U103.46 (USB_DM)
/DVDD_1.1V: C103.1, C104.1, C113.1, U103.23 (DVDD), U103.45 (VREG_VOUT), U103.50 (DVDD)
/LED Driver B/LED_V+: J107.1; also elsewhere on the board
/LED Driver B/LED_V-: J107.2; also elsewhere on the board
/LED Driver O/LED_V+: J108.1; also elsewhere on the board
/LED Driver O/LED_V-: J108.2; also elsewhere on the board
/LED Driver Symbol/LED_V+: J105.1; also elsewhere on the board
/LED Driver Symbol/LED_V-: J105.2; also elsewhere on the board
/LED Driver X (Right)/LED_V+: J109.1; also elsewhere on the board
/LED Driver X (Right)/LED_V-: J109.2; also elsewhere on the board
/LED Driver X (left)/LED_V+: J106.1; also elsewhere on the board
/LED Driver X (left)/LED_V-: J106.2; also elsewhere on the board
/LED_BRIGHNESS_B: U103.31 (GPIO20); also elsewhere on the board
/LED_BRIGHNESS_O: U103.30 (GPIO19); also elsewhere on the board
/LED_BRIGHNESS_SYM: U103.34 (GPIO22); also elsewhere on the board
/LED_BRIGHNESS_XL: U103.32 (GPIO21); also elsewhere on the board
/LED_BRIGHNESS_XR: U103.29 (GPIO18); also elsewhere on the board
/QSPI_CLK: U103.52 (QSPI_SCLK), U104.6 (CLK)
/QSPI_SD0: U103.53 (QSPI_SD0), U104.5 (DI/IO_{0})
/QSPI_SD1: U103.55 (QSPI_SD1), U104.2 (DO/IO_{1})
/QSPI_SD2: U103.54 (QSPI_SD2), U104.3 (~WP/IO_{2})
/QSPI_SD3: U103.51 (QSPI_SD3), U104.7 (~HOLD/~RESET/IO_{3})
/QSPI_~CS: R103.2, R107.2, U103.56 (QSPI_SS), U104.1 (~CS)
/RUN: J102.4, R102.2, U103.26 (RUN)
/RUN_SW: R102.1, SW101.2
/SWCLK: J102.3, U103.24 (SWCLK)
/SWD: J102.2, U103.25 (SWD)
/UART0_MCU_RX: J103.2, U103.3 (GPIO1)
/UART0_MCU_TX: J103.1, U103.2 (GPIO0)
/VBUS_CON: F101.1, J101.1
/XIN: C116.1, U103.20 (XIN), Y101.1
/XO_CRYSTAL: C117.1, R106.1, Y101.2
/XO_MCU: R106.2, U103.21 (XOUT)
/~BTN: C112.1, J104.1, R101.1, U103.27 (GPIO16)
/~USB_BOOT: R103.1, SW102.2
GND: C101.2, C102.2, C103.2, C104.2, C105.2, C106.2, C107.2, C108.2, C109.2, C110.2, C111.2, C112.2, C113.2, C114.2, C115.2, C116.2, C117.2, H103.1, H104.1, J101.4, J102.5, J103.3, J104.2, SW101.1, SW102.1, U101.2 (GND), U102.1 (VN), U103.19 (TESTEN), U103.57 (GND), U104.4 (GND); also elsewhere on the board
VBUS: C101.1, F101.2, U101.1 (IN), U101.3 (EN), U102.4 (VP); also elsewhere on the board

Notes on the sheet:
LED Drivers
3.3V Regulator
12 MHz Clock
Debug Switches
SWD Connector
Flash
UART Connector
MCU
USB/Power In
Debug Connectors
User Button
Place close to pin 45
Place close to pin 44
Distribute 100nF caps to power pins

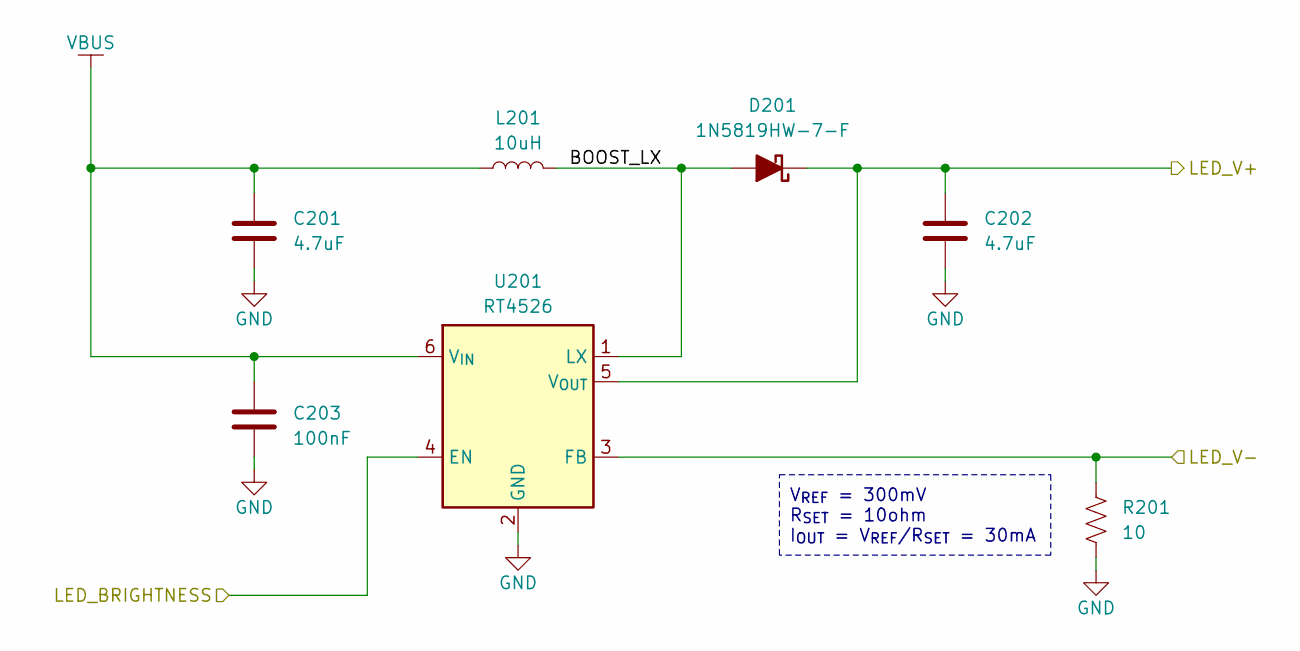
[picture p79: schematic led_driver.kicad_sch]

Parts:
C201: 4.7uF; C_0805_2012Metric; MPN CL21A475KBQNNNE; LCSC PN C98192
C202: 4.7uF; C_1206_3216Metric; MPN GRM31CR71H475KA12L; LCSC PN C77096
C203: 100nF; C_0402_1005Metric; MPN CL05B104KO5NNNC; DigiKey PN 1276-1006-1-ND
D201: 1N5819HW-7-F; D_SOD-123; MPN 1N5819HW-7-F; LCSC PN C82544
L201: 10uH; L_TDK_NLV25_2.5x2.0mm; MPN VLS252012HBX-100M-1; LCSC PN C88532
R201: 10; R_0402_1005Metric; MPN RC0402FR-0710RL; LCSC PN C138066
U201: RT4526; TSOT-23-6; MPN RT4526; LCSC PN C425168

Connections:
/LED Driver Symbol/BOOST_LX: D201.2 (A), L201.2, U201.1 (LX)
/LED Driver Symbol/LED_V+: C202.1, D201.1 (K), U201.5 (V_{OUT}); also elsewhere on the board
/LED Driver Symbol/LED_V-: R201.1, U201.3 (FB); also elsewhere on the board
/LED_BRIGHNESS_SYM: U201.4 (EN); also elsewhere on the board
GND: C201.2, C202.2, C203.2, R201.2, U201.2 (GND); also elsewhere on the board
VBUS: C201.1, C203.1, L201.1, U201.6 (V_{IN}); also elsewhere on the board

Parts of its further copies:
C301, C401, C501, C601: 4.7uF; C_0805_2012Metric; MPN CL21A475KBQNNNE; LCSC PN C98192
C302, C402, C502, C602: 4.7uF; C_1206_3216Metric; MPN GRM31CR71H475KA12L; LCSC PN C77096
C303, C403, C503, C603: 100nF; C_0402_1005Metric; MPN CL05B104KO5NNNC; DigiKey PN 1276-1006-1-ND
D301, D401, D501, D601: 1N5819HW-7-F; D_SOD-123; MPN 1N5819HW-7-F; LCSC PN C82544
L301, L401, L501, L601: 10uH; L_TDK_NLV25_2.5x2.0mm; MPN VLS252012HBX-100M-1; LCSC PN C88532
R301, R401, R501, R601: 10; R_0402_1005Metric; MPN RC0402FR-0710RL; LCSC PN C138066
U301, U401, U501, U601: RT4526; TSOT-23-6; MPN RT4526; LCSC PN C425168

Connections of its further copies:
/LED Driver B/BOOST_LX: D401.2 (A), L401.2, U401.1 (LX)
/LED Driver B/LED_V+: C402.1, D401.1 (K), U401.5 (V_{OUT}); also elsewhere on the board
/LED Driver B/LED_V-: R401.1, U401.3 (FB); also elsewhere on the board
/LED Driver O/BOOST_LX: D501.2 (A), L501.2, U501.1 (LX)
/LED Driver O/LED_V+: C502.1, D501.1 (K), U501.5 (V_{OUT}); also elsewhere on the board
/LED Driver O/LED_V-: R501.1, U501.3 (FB); also elsewhere on the board
/LED Driver X (Right)/BOOST_LX: D601.2 (A), L601.2, U601.1 (LX)
/LED Driver X (Right)/LED_V+: C602.1, D601.1 (K), U601.5 (V_{OUT}); also elsewhere on the board
/LED Driver X (Right)/LED_V-: R601.1, U601.3 (FB); also elsewhere on the board
/LED Driver X (left)/BOOST_LX: D301.2 (A), L301.2, U301.1 (LX)
/LED Driver X (left)/LED_V+: C302.1, D301.1 (K), U301.5 (V_{OUT}); also elsewhere on the board
/LED Driver X (left)/LED_V-: R301.1, U301.3 (FB); also elsewhere on the board
/LED_BRIGHNESS_B: U401.4 (EN); also elsewhere on the board
/LED_BRIGHNESS_O: U501.4 (EN); also elsewhere on the board
/LED_BRIGHNESS_XL: U301.4 (EN); also elsewhere on the board
/LED_BRIGHNESS_XR: U601.4 (EN); also elsewhere on the board
GND: C301.2, C302.2, C303.2, C401.2, C402.2, C403.2, C501.2, C502.2, C503.2, C601.2, C602.2, C603.2, R301.2, R401.2, R501.2, R601.2, U301.2 (GND), U401.2 (GND), U501.2 (GND), U601.2 (GND); also elsewhere on the board
VBUS: C301.1, C303.1, C401.1, C403.1, C501.1, C503.1, C601.1, C603.1, L301.1, L401.1, L501.1, L601.1, U301.6 (V_{IN}), U401.6 (V_{IN}), U501.6 (V_{IN}), U601.6 (V_{IN}); also elsewhere on the board

Notes on the sheet:
V_{REF} = 300mV R_{SET} = 10ohm I_{OUT} = V_{REF}/R_{SET} = 30mA

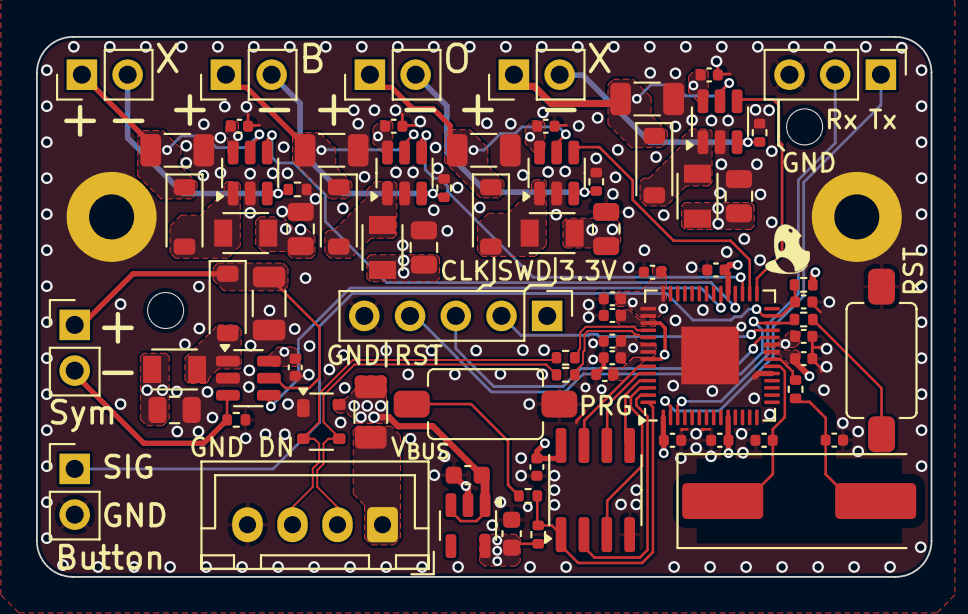
[picture p80: board Control Board.kicad_pcb from above]

Board: 4 copper layers, 49.7 x 30.0 mm, 80 parts (0 on the bottom side), 46 nets.
