Acliad/XBOX-Sign/Hardware/USB-C Board/USB-C Board.kicad_pcb

## KiCad design Hardware/USB-C Board/USB-C Board.kicad_pcb (2025-08-16)

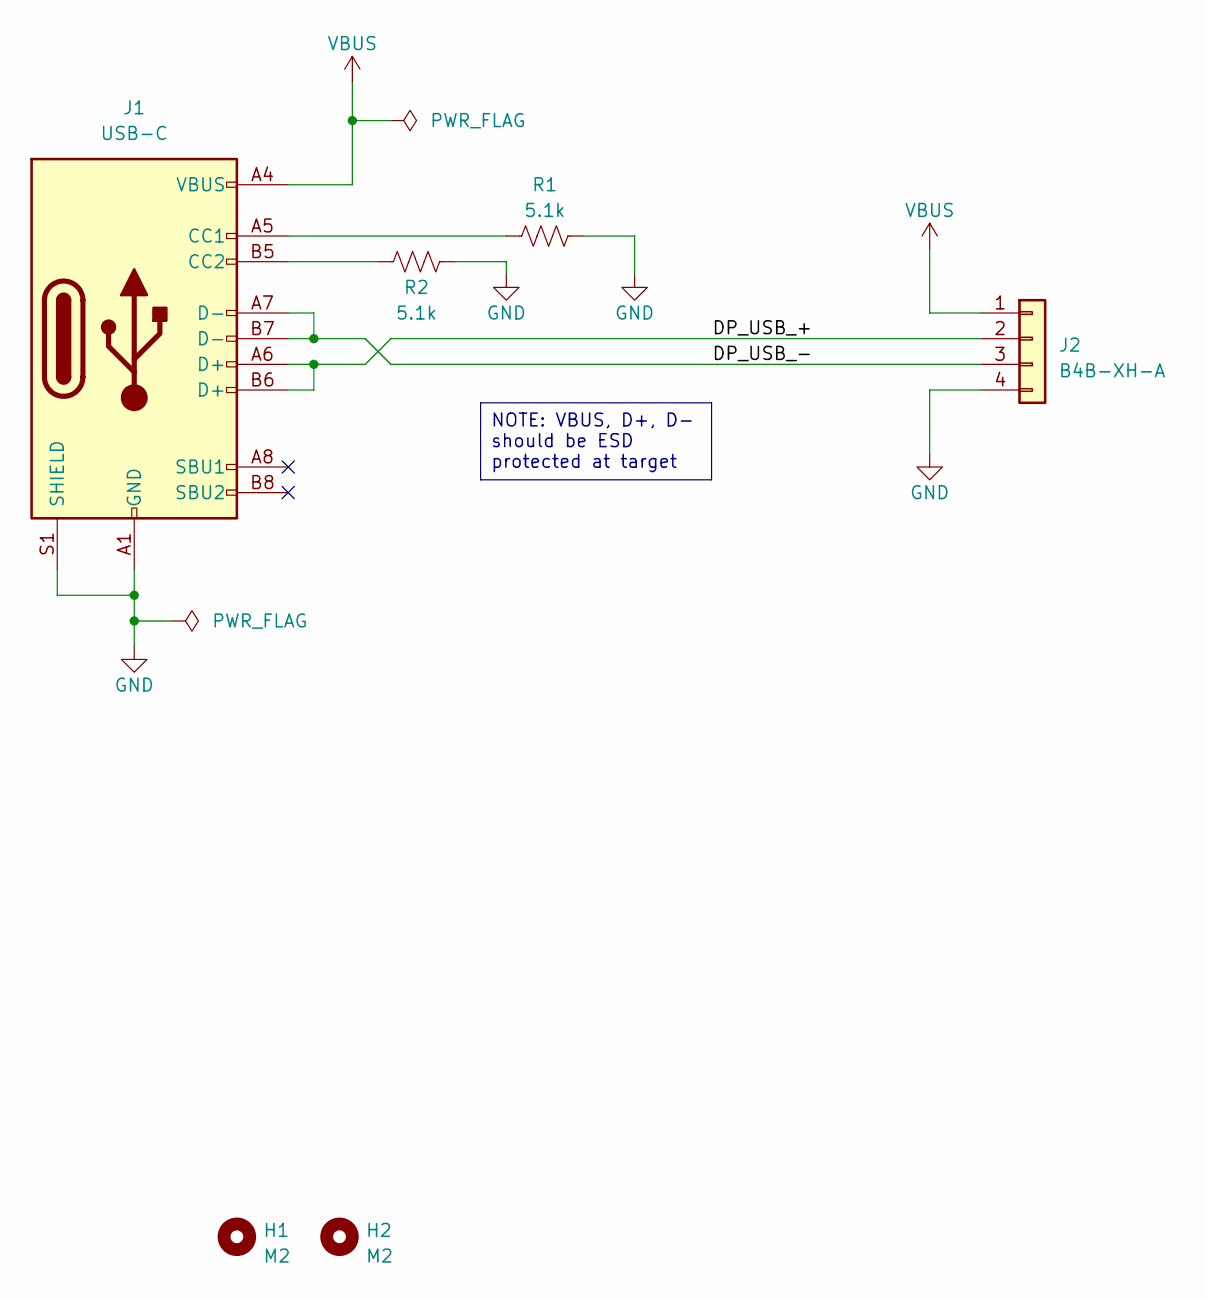
[picture p81: schematic USB-C Board.kicad_sch, USB-C Breakout]

Parts:
H1, H2: M2; MountingHole_2.2mm_M2
J1: USB-C; USB_C_Receptacle_GCT_USB4105-GF-A-060; MPN USB4105-GF-A-060; DigiKey PN 2073-USB4105-GF-A-060CT-ND
J2: B4B-XH-A; JST_XH_B4B-XH-A_1x04_P2.50mm_Vertical; MPN B4B-XH-A; DigiKey PN 455-2237-ND
R1, R2: 5.1k; R_0603_1608Metric; MPN VENDOR SELECT; DigiKey PN CR0603-FX-5101ELFCT-ND

Connections:
/DP_USB_+: J1.A6 (D+), J1.B6 (D+), J2.2
/DP_USB_-: J1.A7 (D-), J1.B7 (D-), J2.3
GND: J1.A1 (GND), J1.A12 (GND), J1.B1 (GND), J1.B12 (GND), J1.S1 (SHIELD), J2.4, R1.2, R2.2
unnamed: J1.A5 (CC1), R1.1
unnamed: J1.B5 (CC2), R2.1
VBUS: J1.A4 (VBUS), J1.A9 (VBUS), J1.B4 (VBUS), J1.B9 (VBUS), J2.1

Notes on the sheet:
NOTE: VBUS, D+, D- should be ESD protected at target

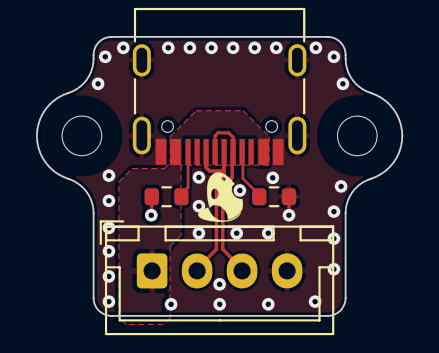
[picture p82: board USB-C Board.kicad_pcb from above]

Board: 2 copper layers, 20.3 x 15.5 mm, 6 parts (0 on the bottom side), 6 nets.
