Acliad/XBOX-Sign/Software/include/led_transition_lut.h

/**
 * @file led_transition_lut.h
 * @author Isaac Rex (@Acliad)
 * @brief Contains a lookup table for smooth LED brightness transitions.
 * @version 0.1
 * @date 2025-09-18
 *
 * @copyright Copyright (c) 2025
 *
 */

#pragma once
#include <stdint.h>

#define LED_LUT_SIZE 1024

static const float LED_LUT_S_CURVE[LED_LUT_SIZE] = {
    0.000000f, 0.000179f, 0.000360f, 0.000542f, 0.000725f, 0.000910f, 0.001095f, 0.001282f, 0.001471f, 0.001660f,
    0.001851f, 0.002043f, 0.002237f, 0.002432f, 0.002628f, 0.002826f, 0.003024f, 0.003225f, 0.003426f, 0.003629f,
    0.003834f, 0.004040f, 0.004247f, 0.004456f, 0.004666f, 0.004877f, 0.005090f, 0.005305f, 0.005520f, 0.005738f,
    0.005957f, 0.006177f, 0.006399f, 0.006622f, 0.006847f, 0.007074f, 0.007302f, 0.007531f, 0.007762f, 0.007995f,
    0.008229f, 0.008465f, 0.008702f, 0.008941f, 0.009182f, 0.009424f, 0.009668f, 0.009914f, 0.010161f, 0.010410f,
    0.010660f, 0.010913f, 0.011167f, 0.011422f, 0.011680f, 0.011939f, 0.012200f, 0.012463f, 0.012727f, 0.012993f,
    0.013261f, 0.013531f, 0.013803f, 0.014076f, 0.014351f, 0.014629f, 0.014908f, 0.015188f, 0.015471f, 0.015756f,
    0.016042f, 0.016331f, 0.016621f, 0.016914f, 0.017208f, 0.017504f, 0.017802f, 0.018103f, 0.018405f, 0.018709f,
    0.019015f, 0.019323f, 0.019634f, 0.019946f, 0.020261f, 0.020577f, 0.020896f, 0.021217f, 0.021539f, 0.021864f,
    0.022192f, 0.022521f, 0.022852f, 0.023186f, 0.023522f, 0.023860f, 0.024200f, 0.024543f, 0.024887f, 0.025234f,
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
    0.267238f, 0.268767f, 0.270301f, 0.271840f, 0.273383f, 0.274932f, 0.276485f, 0.278043f, 0.279606f, 0.281174f,
    0.282746f, 0.284323f, 0.285905f, 0.287491f, 0.289082f, 0.290678f, 0.292278f, 0.293883f, 0.295492f, 0.297106f,
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
