Acliad/XBOX-Sign/Software/include/led_gamma_correction_table.h

/**
 * @file led_gamma_correction_table.h
 * @author Isaac Rex (@Acliad)
 * @brief LUT for gamma correction of LED brightness
 * @version 0.1
 * @date 2025-09-18
 *
 * @copyright Copyright (c) 2025
 *
 */

#pragma once

#include "led.h"
#include <stdint.h>

#define LED_GAMMA_TABLE_SIZE (LED_MAX_BRIGHTNESS + 1)

static const uint32_t LED_GAMMA_CORRECTION_TABLE[LED_GAMMA_TABLE_SIZE] = {
    0,    0,    0,    0,    0,    0,    0,    0,    0,    0,    0,    0,    0,    0,    0,    0,    0,    0,    0,
    0,    0,    0,    0,    0,    0,    0,    0,    0,    0,    0,    0,    0,    0,    0,    0,    0,    0,    0,
    0,    0,    0,    0,    0,    0,    0,    0,    0,    0,    0,    0,    0,    0,    0,    0,    0,    0,    0,
    0,    0,    0,    0,    0,    0,    0,    0,    0,    0,    0,    0,    0,    0,    0,    0,    0,    0,    0,
    0,    0,    0,    0,    0,    0,    0,    0,    0,    0,    0,    0,    0,    0,    0,    0,    0,    0,    0,
    0,    0,    0,    0,    0,    0,    0,    0,    0,    0,    0,    0,    0,    0,    0,    0,    0,    0,    0,
    0,    0,    0,    0,    0,    0,    0,    0,    0,    0,    0,    0,    0,    0,    0,    0,    0,    0,    0,
    0,    0,    0,    0,    0,    0,    0,    0,    0,    0,    0,    0,    0,    0,    0,    0,    0,    0,    0,
    0,    0,    0,    0,    0,    0,    0,    0,    0,    0,    0,    0,    0,    0,    0,    0,    0,    0,    0,
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
    90,   90,   91,   91,   91,   91,   92,   92,   92,   92,   93,   93,   93,   94,   94,   94,   94,   95,   95,
    95,   96,   96,   96,   96,   97,   97,   97,   98,   98,   98,   98,   99,   99,   99,   100,  100,  100,  100,
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
