Acliad/XBOX-Sign/(commit log)

2025-08-10 Iniital commit
    [Board Outline.dxf, LED Placement.dxf, Light Board - X.kicad_pcb, Light Board - X.kicad_sch]
2025-08-11 Added production file generation tools
    [BOM.csv, BOM_itemized.csv, Light Board - X.kicad_pcb, Light Board - X.kicad_sch, Light Board - X.step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]
2025-08-11 Added O lightboard
    [BOM.csv, BOM_itemized.csv, Board Outline.dxf, LED Placement.dxf, Light Board - O.kicad_pcb, Light Board - O.kicad_sch, Light Board - O.step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]
2025-08-16 Finished all light boards
    [BOM.csv, BOM_itemized.csv, Board Outline.dxf, LED Placement.dxf, Light Board - B.kicad_pcb, Light Board - B.kicad_sch, Light Board - B.step, Light Board - O.kicad_pcb]
2025-08-16 Added USB-C board
    [BOM.csv, BOM_itemized.csv, Board Outline.dxf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]
2025-08-16 Added control board
    [Board Outline.dxf, Control Board.kicad_pcb, Control Board.kicad_sch, led_driver.kicad_sch]
2025-08-16 Added stiching vias, 3D models
    [Control Board.kicad_pcb]
2025-08-16 Added release files
    [BOM.csv, BOM_itemized.csv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]
2025-08-16 Updated letter gerbers to 1 layer output
    [Light Board - B.step, Light Board - O.step, Light Board - X.step]
2025-08-25 Added note about incorrect footprint orientation
    [Light Board - B.kicad_sch, Light Board - O.kicad_sch, Light Board - X.kicad_sch]
2025-08-30 Added LED library and fixed orientation
    [Light Board - B.kicad_pcb, Light Board - B.kicad_sch, Light Board - B.step, Light Board - O.kicad_pcb, Light Board - O.kicad_sch, Light Board - O.step, Light Board - Symbol.kicad_pcb, Light Board - Symbol.kicad_sch]
2025-09-19 Mid bringup, moving transistion from led.h to dedicated animation module
2025-09-28 Add button library
